ibpasha1/QuranNode/PartImages/71ASBEVHTSL._AC_SL1500_.jpg

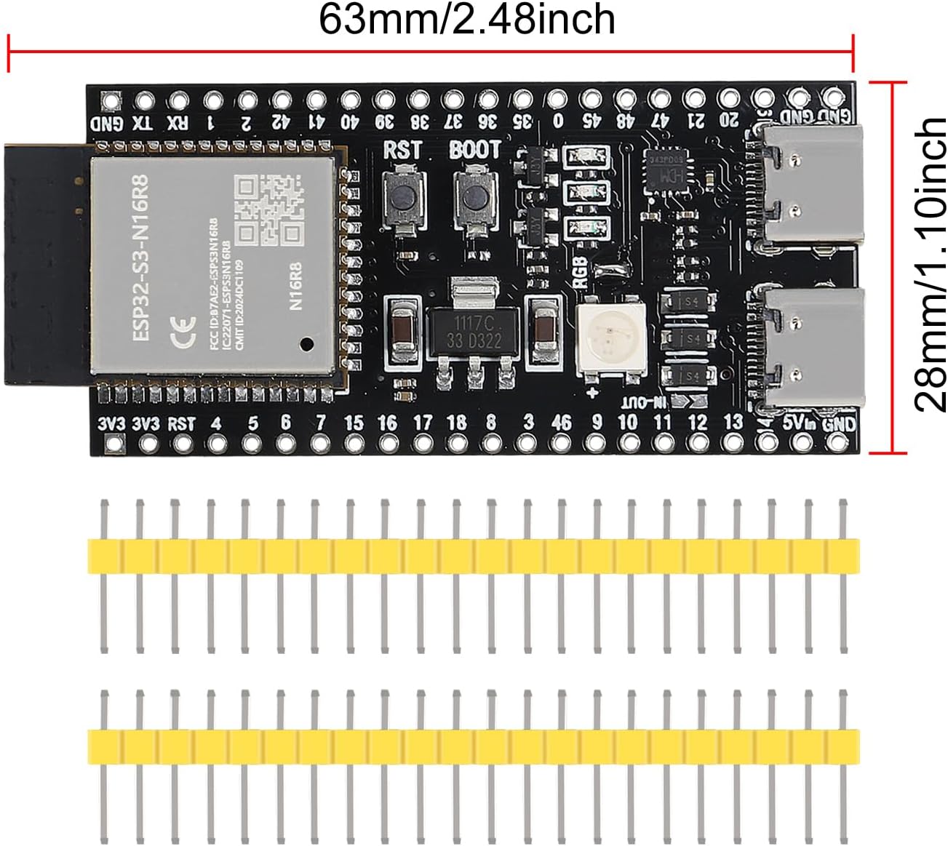
PartImages/71ASBEVHTSL._AC_SL1500_.jpg
