ibpasha1/QuranNode/PartImages/71lFD1bBuXL._AC_SL1500_.jpg

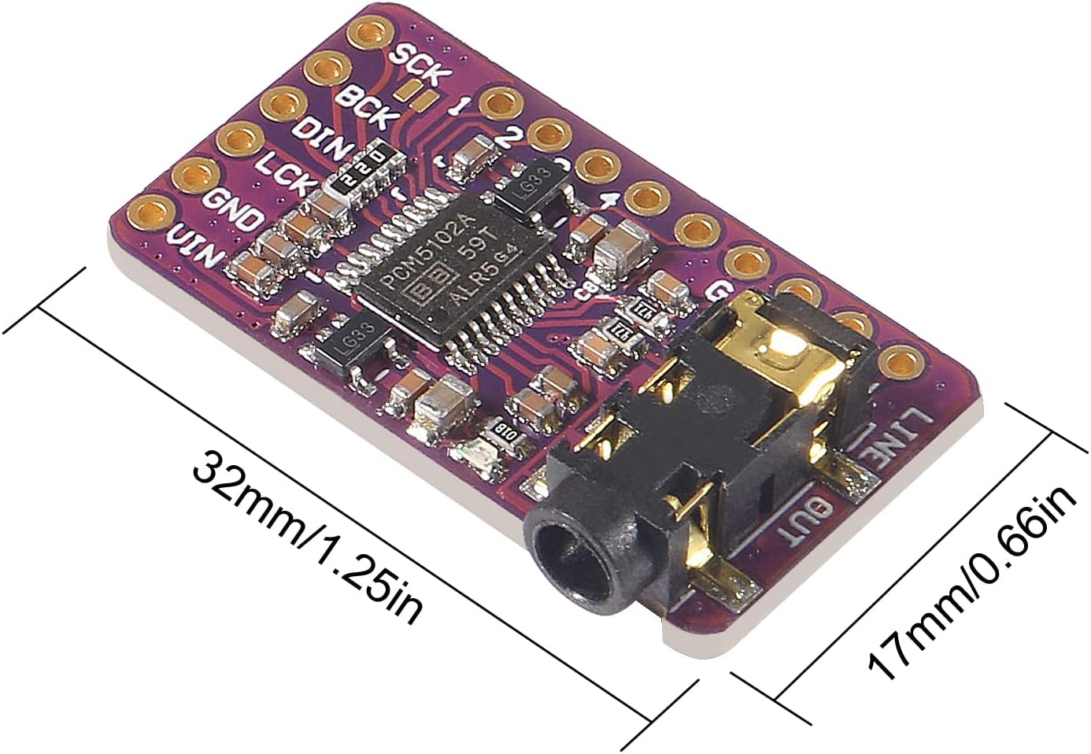
PartImages/71lFD1bBuXL._AC_SL1500_.jpg
