ibpasha1/QuranNode/assets/preview/tajweed/1_7.png

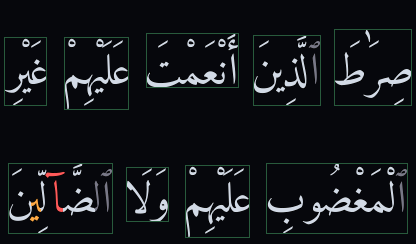
assets/preview/tajweed/1_7.png
