ibpasha1/QuranNode/hardware/enclosure/panelplan.png

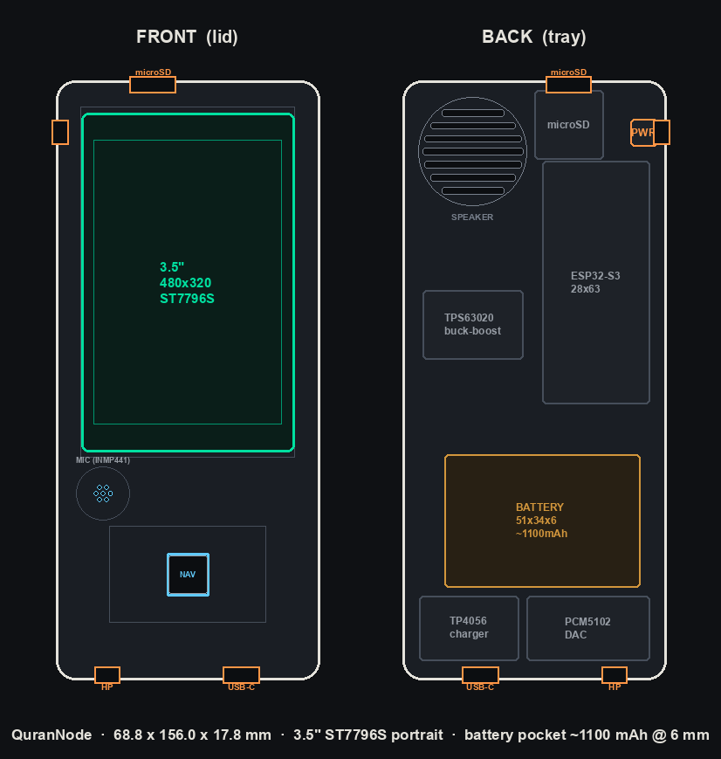
hardware/enclosure/panelplan.png
