ibpasha1/QuranNode/hardware/enclosure/render_exploded.png

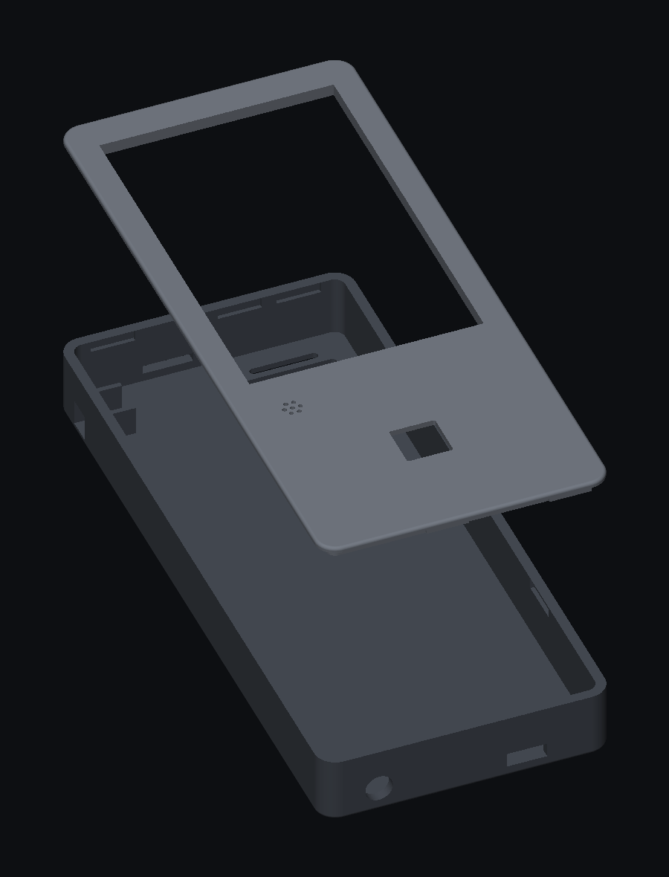
hardware/enclosure/render_exploded.png
