ibpasha1/QuranNode/hardware/enclosure/render_front.png

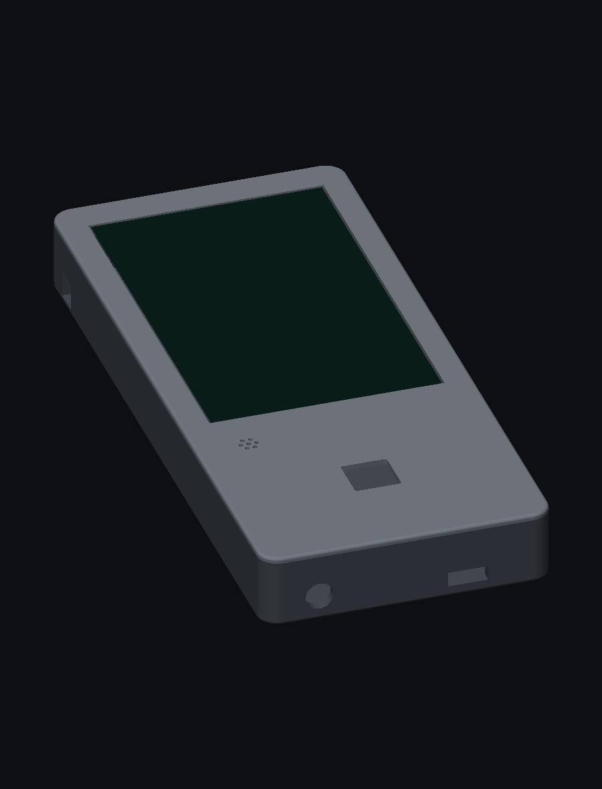
hardware/enclosure/render_front.png
