ibpasha1/QuranNode/hardware/pcb/kicad/qurannode-full.png

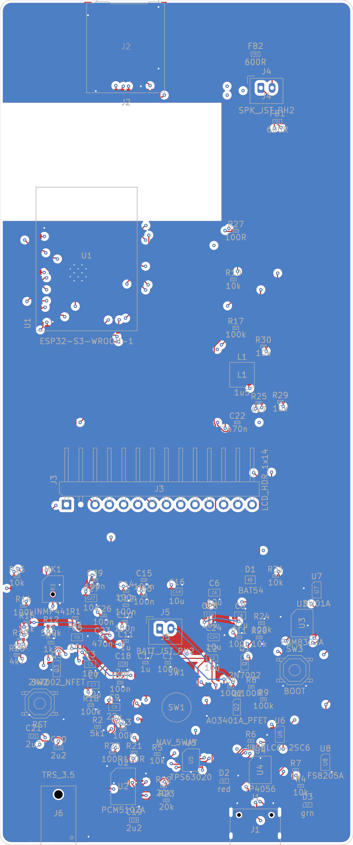
hardware/pcb/kicad/qurannode-full.png
