ibpasha1/QuranNode/hardware/prototype/pinout_preview.png

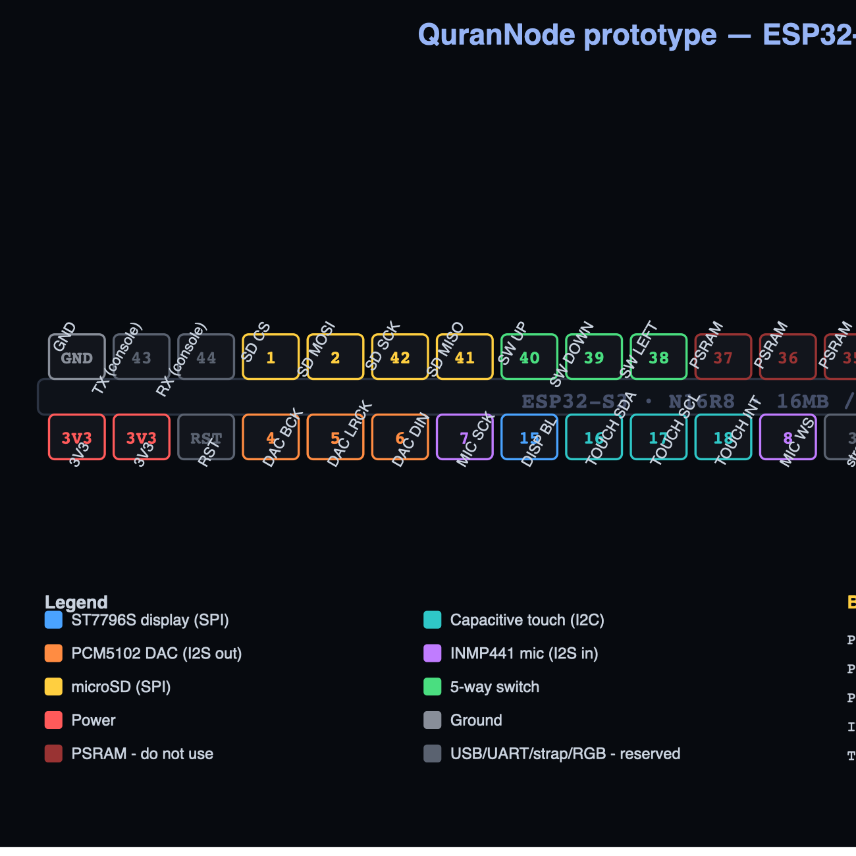
hardware/prototype/pinout_preview.png
