ibpasha1/QuranNode/PartImages/51yFM6gKUXL._SL1001_.jpg

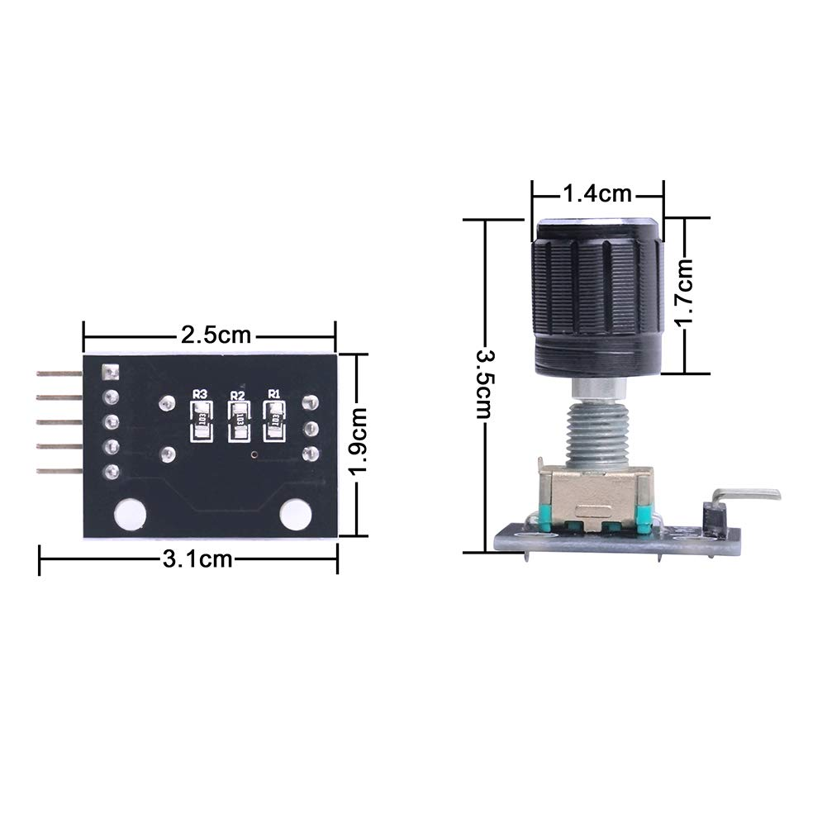
PartImages/51yFM6gKUXL._SL1001_.jpg
