ibpasha1/QuranNode/PartImages/61ehFKd+jKL._AC_SL1001_.jpg

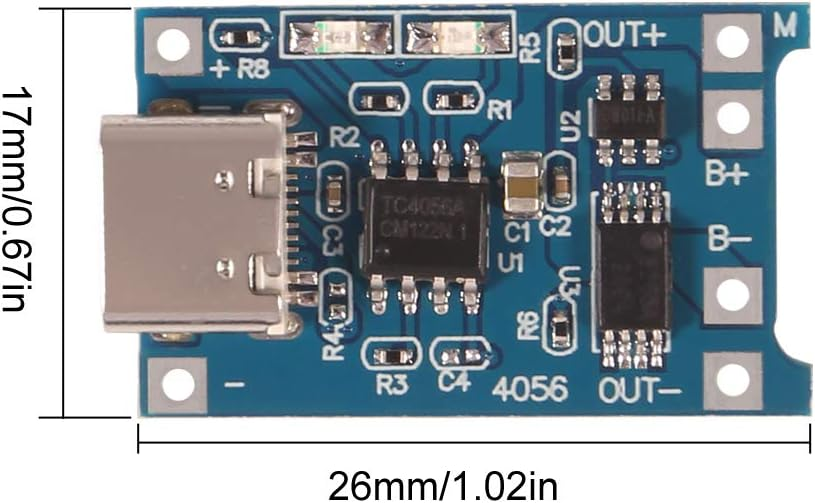
PartImages/61ehFKd+jKL._AC_SL1001_.jpg
