ibpasha1/QuranNode/PartImages/61lymxlfKTL._AC_SL1500_.jpg

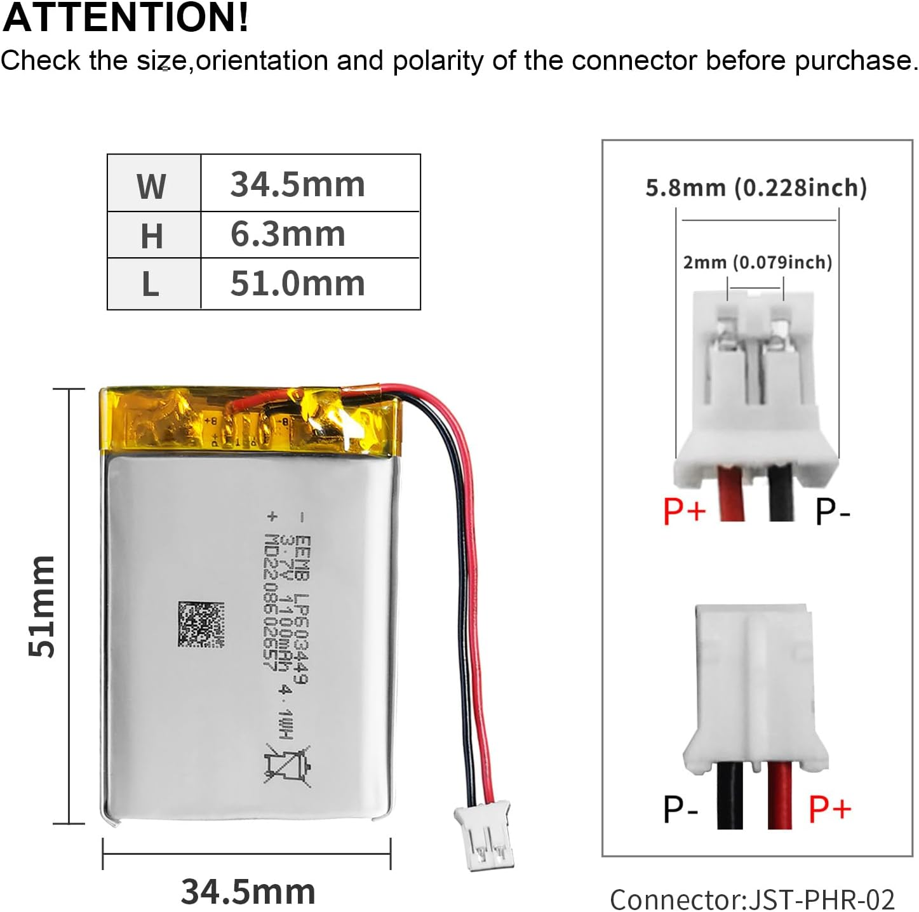
PartImages/61lymxlfKTL._AC_SL1500_.jpg
