ibpasha1/QuranNode/PartImages/61q4yPL2lzL._SL1200_.jpg

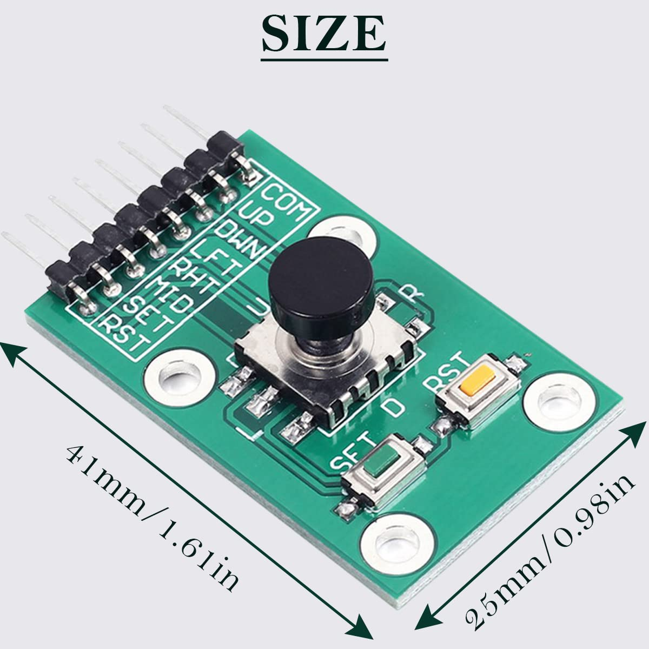
PartImages/61q4yPL2lzL._SL1200_.jpg
