ibpasha1/QuranNode/PartImages/61XXKQeOFkL._SL1000_.jpg

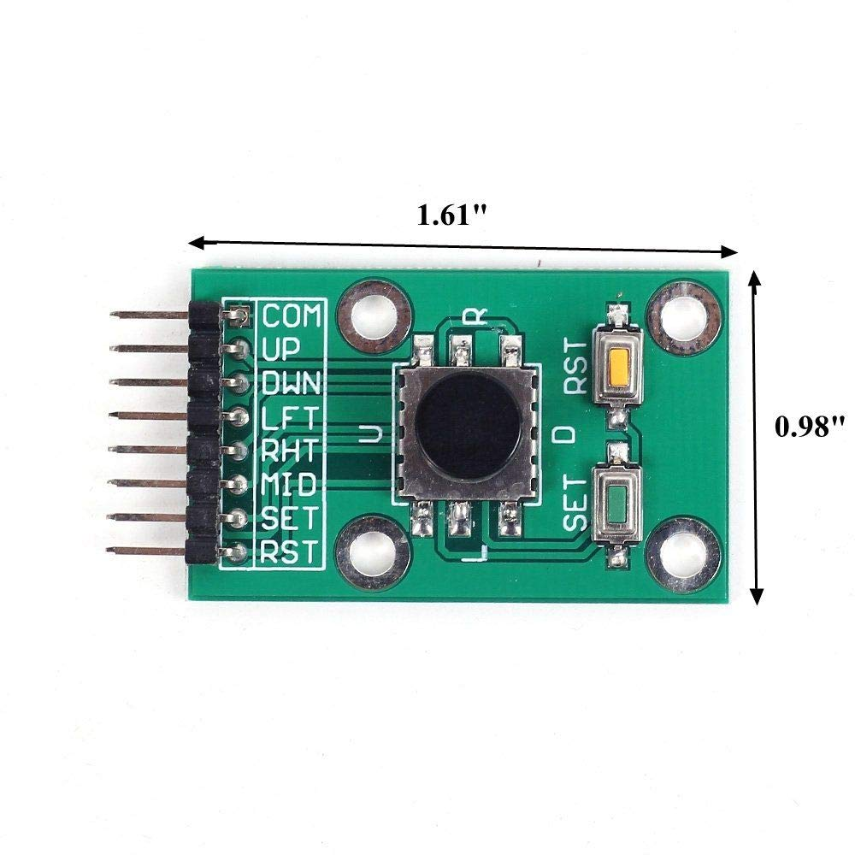
PartImages/61XXKQeOFkL._SL1000_.jpg
