ibpasha1/QuranNode/PartImages/71imCLbJ39L._AC_SL1500_.jpg

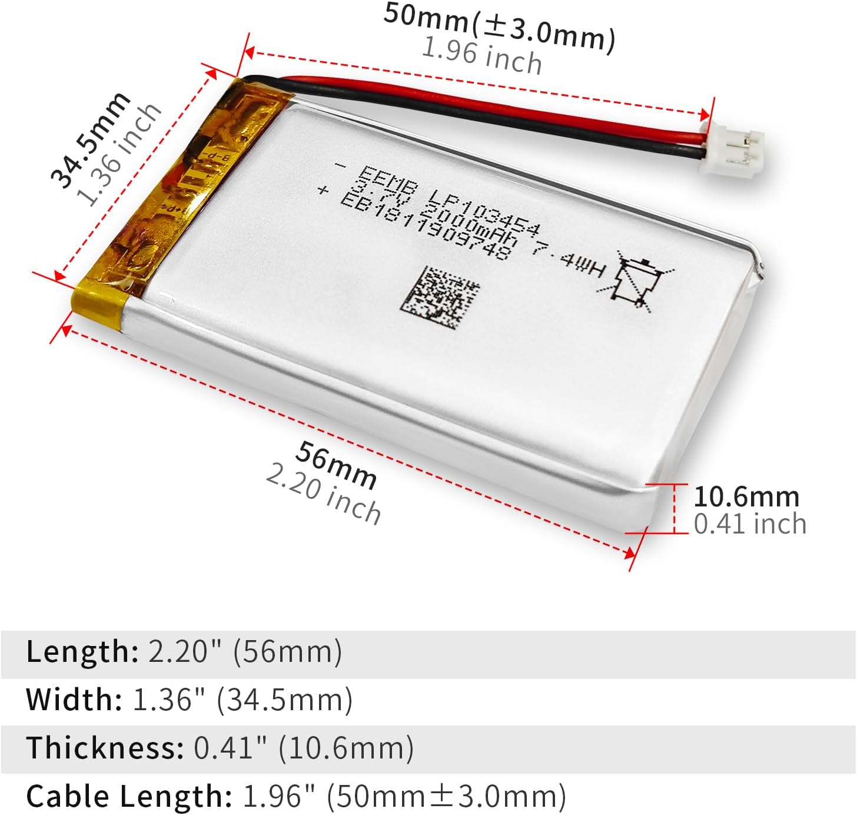
PartImages/71imCLbJ39L._AC_SL1500_.jpg
