ibpasha1/QuranNode/PartImages/71M5cWiFApL._AC_SL1500_.jpg

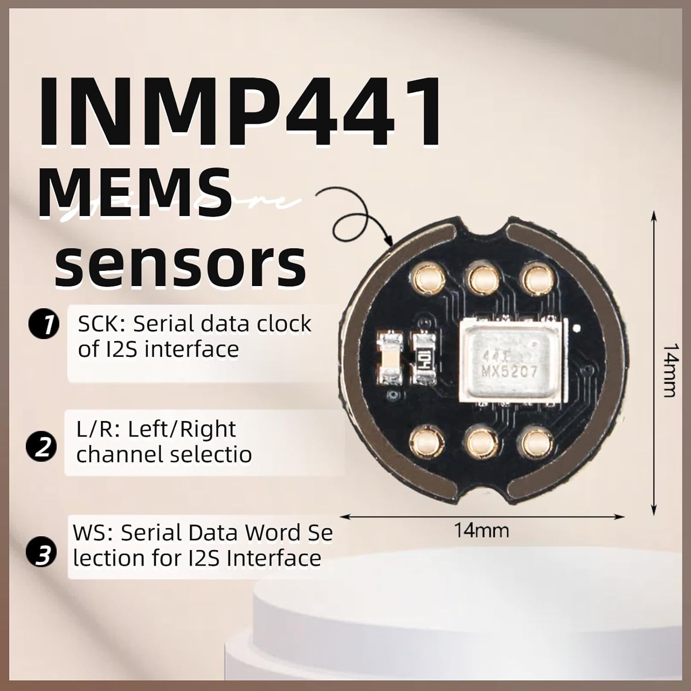
PartImages/71M5cWiFApL._AC_SL1500_.jpg
