ibpasha1/QuranNode/PartImages/71T5YitheYL._AC_SL1500_.jpg

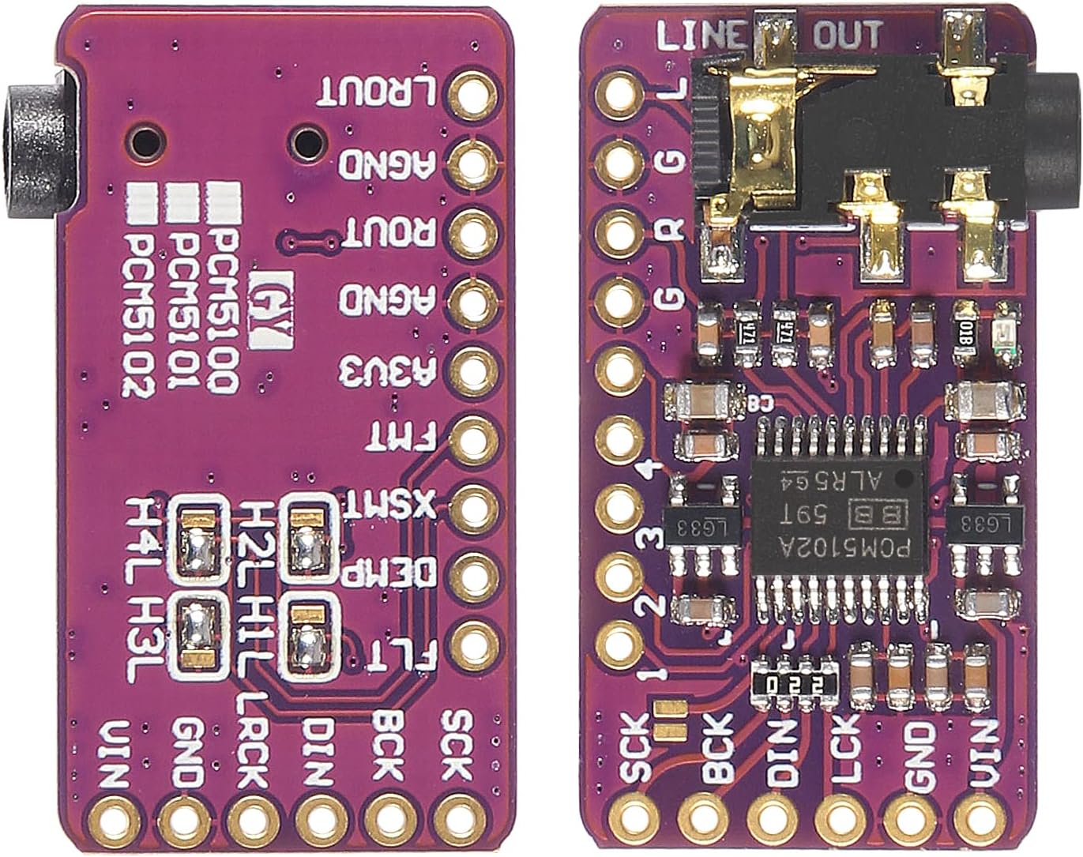
PartImages/71T5YitheYL._AC_SL1500_.jpg
