ibpasha1/QuranNode/PartImages/71UBGr1hEQL._AC_SL1500_.jpg

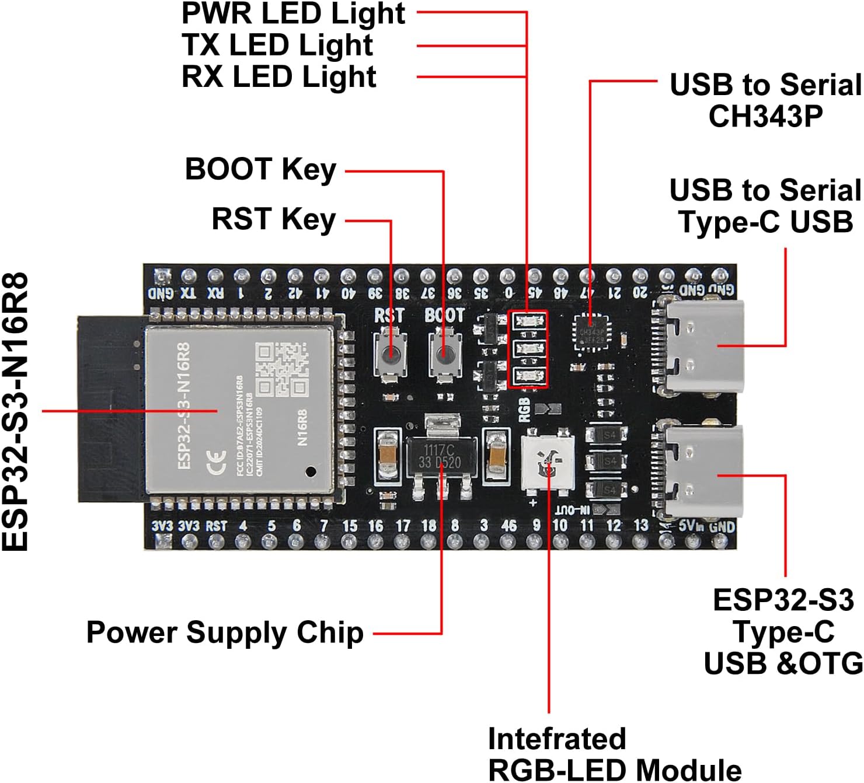
PartImages/71UBGr1hEQL._AC_SL1500_.jpg
