ibpasha1/QuranNode/PartImages/612jbxhP6UL._AC_SL1000_.jpg

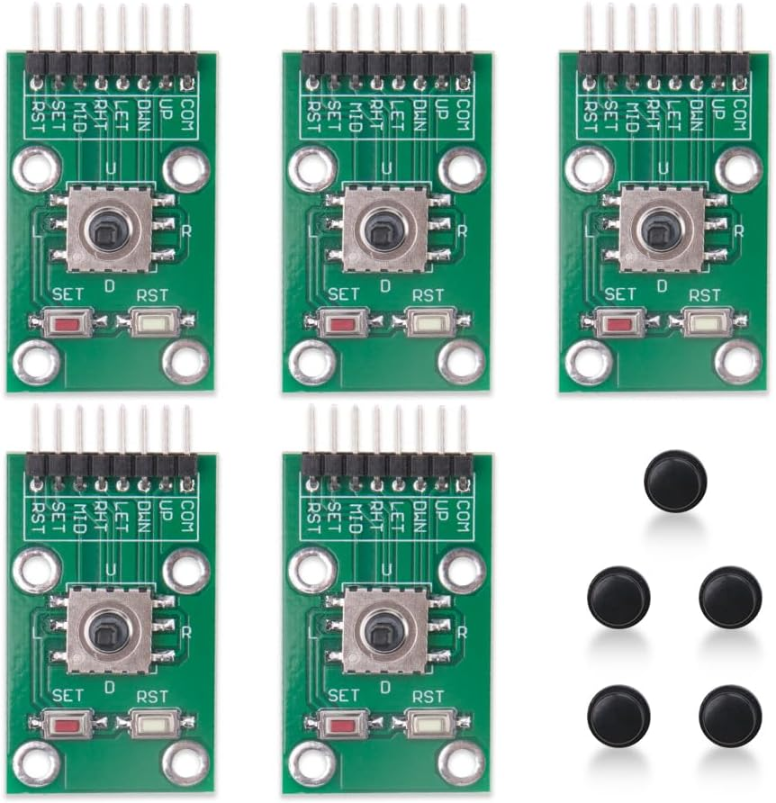
PartImages/612jbxhP6UL._AC_SL1000_.jpg
