ibpasha1/QuranNode/PartImages/616AB7V-gkL._AC_SL1500_.jpg

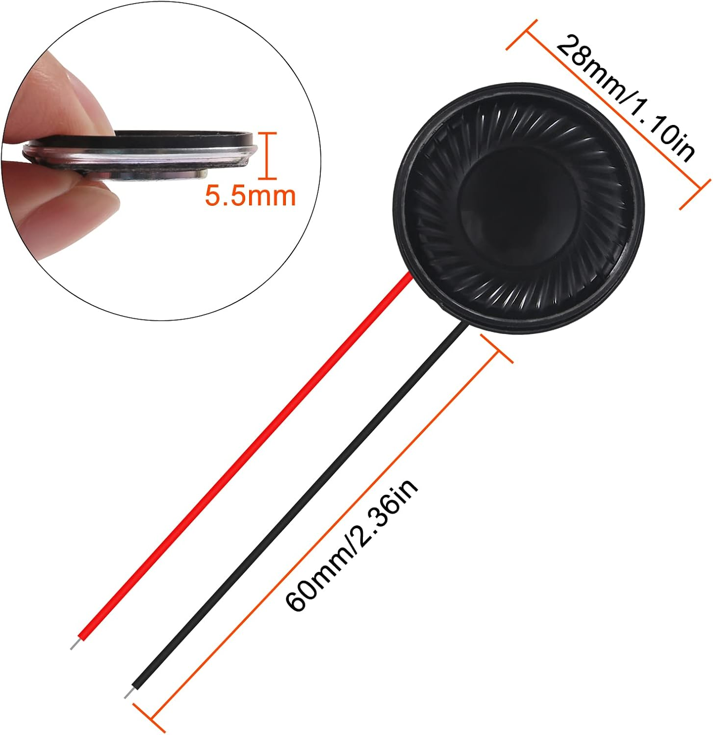
PartImages/616AB7V-gkL._AC_SL1500_.jpg
