ibpasha1/QuranNode/PartImages/Screenshot 2026-08-30 at 1.49.43 PM.png

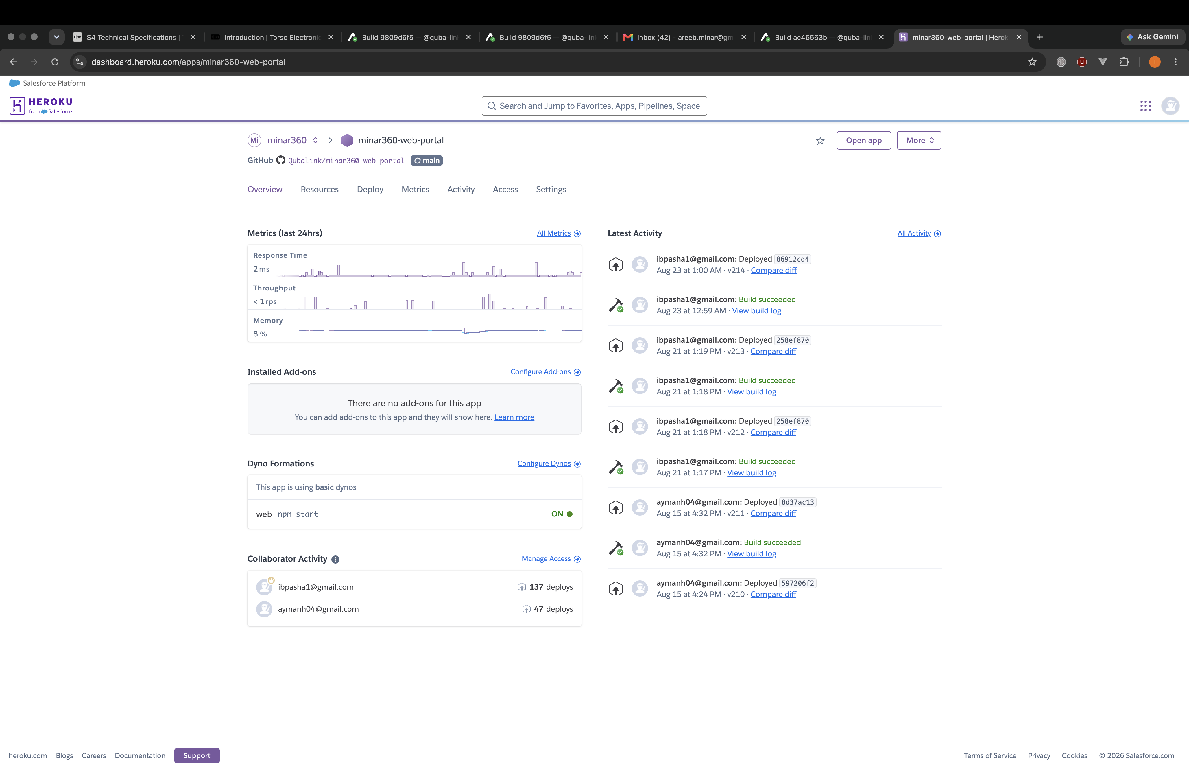
PartImages/Screenshot 2026-08-30 at 1.49.43 PM.png
