ibpasha1/QuranNode/PartImages/Screenshot 2026-08-30 at 2.45.38 PM.png

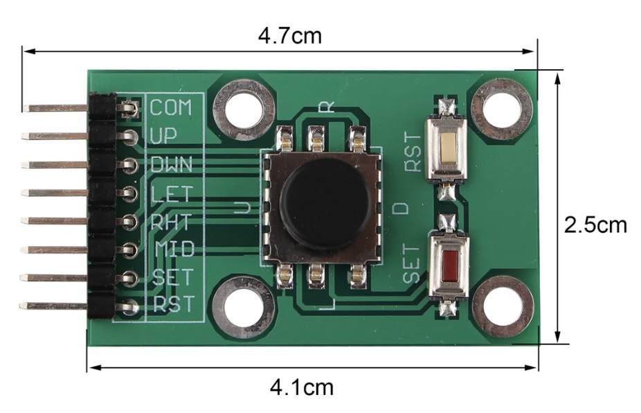
PartImages/Screenshot 2026-08-30 at 2.45.38 PM.png
