ibpasha1/QuranNode/PartImages/Screenshot 2026-08-30 at 2.46.50 PM.png

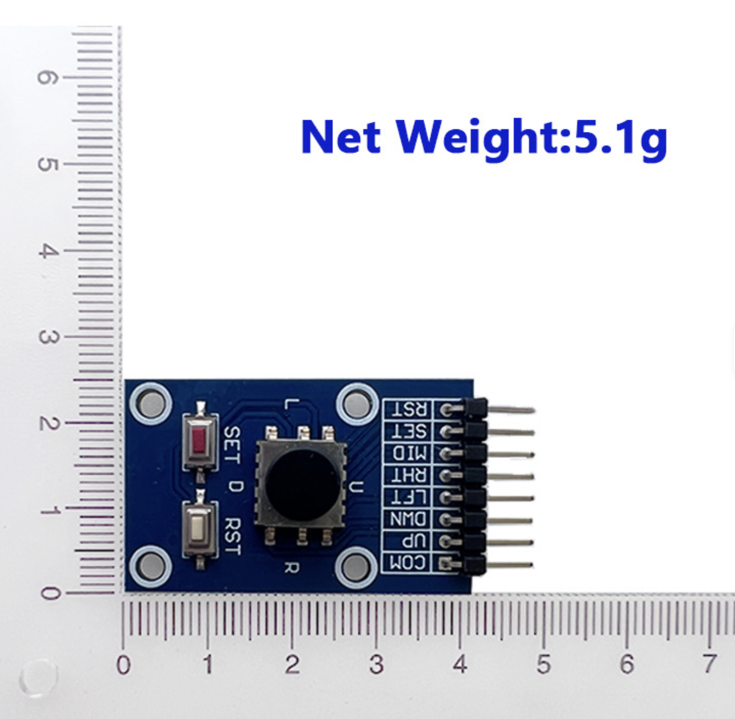
PartImages/Screenshot 2026-08-30 at 2.46.50 PM.png
