ibpasha1/QuranNode/hardware/enclosure/tray.step

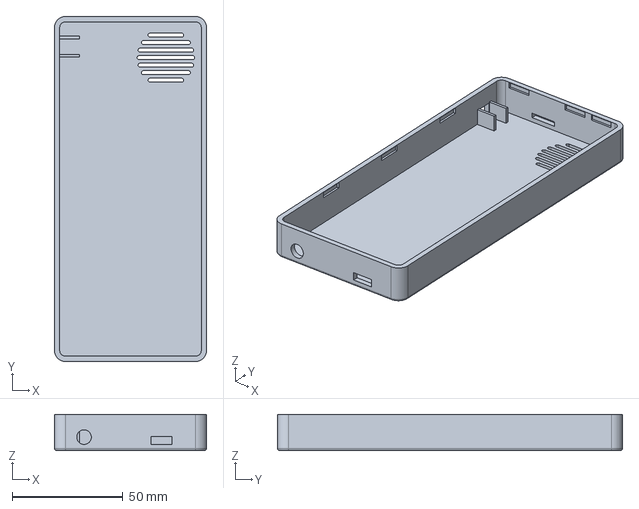
[picture p23: CAD file, 2026-09-13]
hardware/enclosure/tray.step
68.8 x 156.0 x 16.4 mm
