ibpasha1/QuranNode/hardware/pcb/kicad/qurannode-outline.dxf

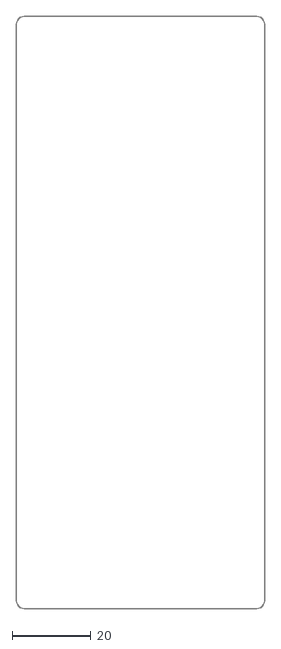
[picture p24: CAD file, 2026-09-16]
hardware/pcb/kicad/qurannode-outline.dxf
62.8 x 150.0
