ibpasha1/QuranNode/hardware/enclosure/lid.step

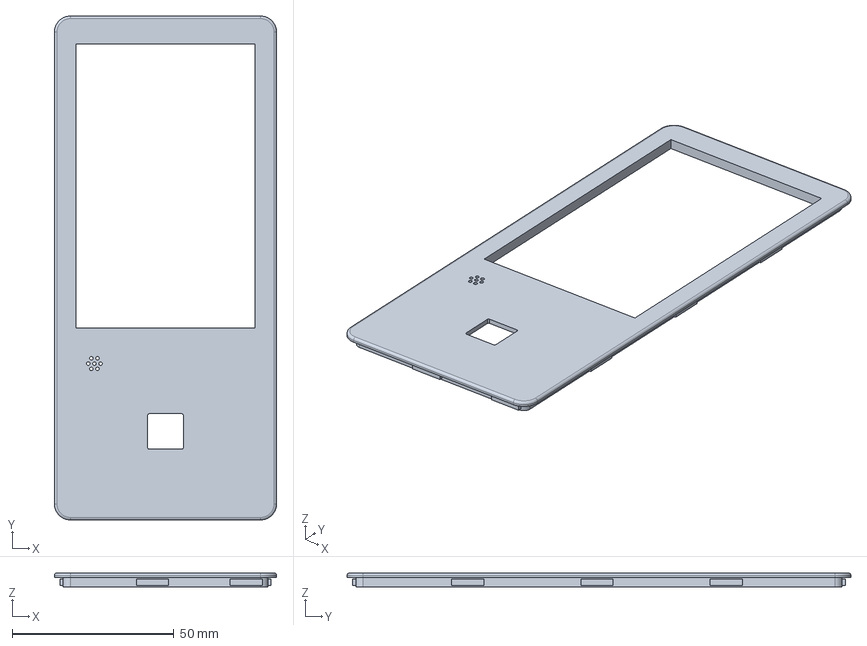
[picture p25: CAD file, 2026-09-13]
hardware/enclosure/lid.step
68.8 x 156.0 x 4.40 mm
