ibpasha1/QuranNode/hardware/enclosure/qurannode_enclosure.step

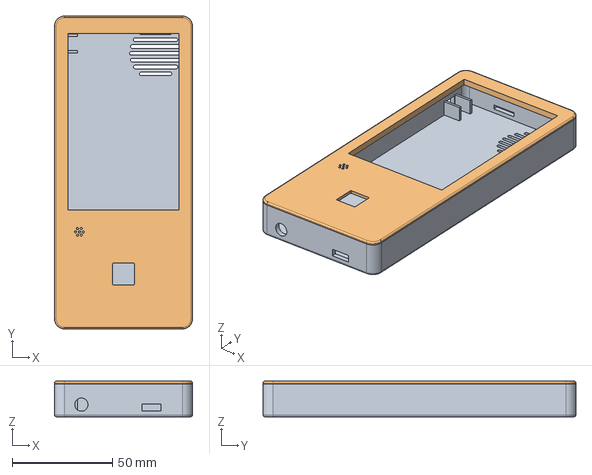
[picture p26: CAD file, 2026-09-13]
hardware/enclosure/qurannode_enclosure.step
68.8 x 156.0 x 17.8 mm
