ibpasha1/QuranNode/(list of files, cad)

Other CAD files:
hardware/enclosure/lid.stl
hardware/enclosure/qurannode_enclosure.FCStd
hardware/enclosure/tray.stl
