ibpasha1/QuranNode/hardware/pcb/kicad/qurannode.kicad_pcb

## KiCad design hardware/pcb/kicad/qurannode.kicad_pcb (2026-09-16)

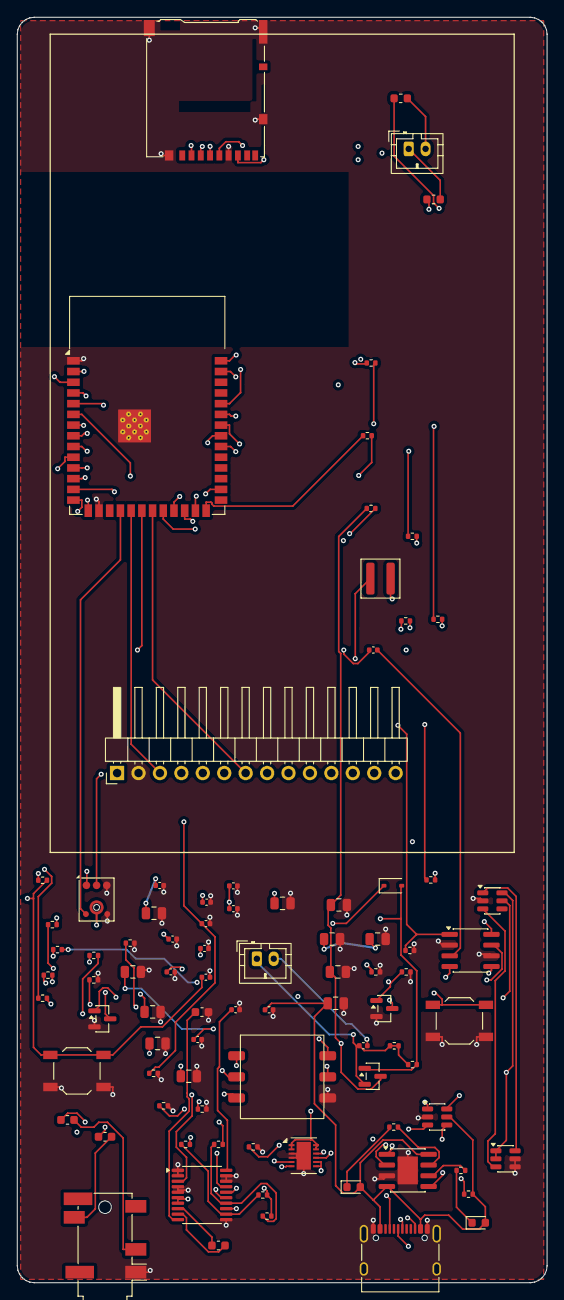
[picture p27: board qurannode.kicad_pcb from above]

Board: 4 copper layers, 62.8 x 150.0 mm, 87 parts (0 on the bottom side), 74 nets.

Parts:
C1, C4, C10, C12, C13, C14, C15, C25, C26, C29: 100n; C_0402_1005Metric
C2, C3, C5, C6, C16, C24, C27, C28: 10u; C_0805_2012Metric
C7, C8, C9: 22u; C_0805_2012Metric
C11, C17: 1u; C_0402_1005Metric
C18, C19, C20, C21: 2u2; C_0603_1608Metric
C22, C23: 470n; C_0402_1005Metric
D1: BAT54; D_SOD-323
D2: red; LED_0603_1608Metric
D3: grn; LED_0603_1608Metric
FB1, FB2: 600R; L_0603_1608Metric
J1: USB-C-16P; USB_C_Receptacle_XKB_U262-16XN-4BVC11
J2: microSD; microSD_HC_Hirose_DM3AT-SF-PEJM5
J3: LCD_HDR_1x14; PinHeader_1x14_P2.54mm_Horizontal
J4: SPK_JST_PH2; JST_PH_B2B-PH-K_1x02_P2.00mm_Vertical
J5: BATT_JST_PH2; JST_PH_B2B-PH-K_1x02_P2.00mm_Vertical
J6: TRS_3.5; Jack_3.5mm_PJ31060-I_Horizontal
L1: 1u5; L_Abracon_ASPIAIG-F4020
MK1: INMP441; Knowles_LGA-6_4.72x3.76mm
Q1: 2N7002; SOT-23
Q2: AO3401A_PFET; SOT-23
Q3: 2N7002_NFET; SOT-23
R1, R2: 5k1; R_0402_1005Metric
R3: 1k2; R_0402_1005Metric
R4, R5, R10, R15, R16, R19, R28, R29, R30, R31: 10k; R_0402_1005Metric
R6, R7: 1k; R_0402_1005Metric
R8, R20, R21, R27: 100R; R_0402_1005Metric
R9, R11, R13, R14, R17, R18, R24: 100k; R_0402_1005Metric
R12: 560k; R_0402_1005Metric
R22, R23: 20k; R_0402_1005Metric
R25, R26: 4k7; R_0402_1005Metric
SW1: NAV_5WAY; NAV_5WAY_SMD
SW2: RST; SW_SPST_TL3342
SW3: BOOT; SW_SPST_TL3342
U1: ESP32-S3-WROOM-1
U2: PCM5102A; TSSOP-20_4.4x6.5mm_P0.65mm
U3: PAM8302A; SOIC-8_3.9x4.9mm_P1.27mm
U4: TP4056; SOIC-8-1EP_3.9x4.9mm_P1.27mm_EP2.41x3.3mm
U5: TPS63020; DFN-12-1EP_3x4mm_P0.5mm_EP1.7x3.3mm
U6: USBLC6-2SC6; SOT-23-6
U7: DW01A; SOT-23-6
U8: FS8205A; SOT-23-6

Connections:
+3V3: C7.1, C8.1, C9.1, C10.1, C13.1, C14.1, C15.1, C16.1, C26.1, C27.1, C28.1, C29.1, J2.4, J3.1, MK1.3, R12.1, R14.2, R15.1, R16.1, R19.2, R25.2, R26.2, R29.2, R30.2, R31.2, U1.2, U2.6, U2.7, U2.13, U5.7, U5.8
AIN: C22.1, R22.2, R23.2
AMP_EN: R24.1, U1.11, U3.1
BL_G: Q1.1, R27.2, R28.1
CHG_CHRG: R6.2, U4.7
CHG_STBY: R7.2, U4.6
DISP_BL: R27.1, U1.8
DISP_CLK: J3.7, U1.21
DISP_CS: J3.3, U1.19
DISP_DC: J3.5, U1.22
DISP_MOSI: J3.6, U1.20
DISP_RST: J3.4, J3.11, U1.23
EN: C11.1, R15.2, SW2.1, U1.3
GND: C1.2, C2.2, C3.2, C5.2, C6.2, C7.2, C8.2, C9.2, C10.2, C11.2, C12.2, C13.2, C14.2, C15.2, C16.2, C17.2, C18.2, C23.2, C24.2, C25.2, C26.2, C27.2, C28.2, C29.2, J1.A1, J1.A12, J1.B1, J1.B12, J1.SH, J2.6, J2.SH, J3.2, J6.S, MK1.4, MK1.5, Q1.2, Q3.2, R1.2, R2.2, R3.2, R5.2, R11.2, R13.2, R18.2, R24.2, R28.2, SW1.6, SW2.2, SW3.2, U1.1, U1.16, U1.41, U2.1, U2.2, U2.4, U2.5, U2.11, U2.18, U2.19, U3.2, U3.6, U4.3, U4.9, U5.3, U5.4, U5.13, U6.2, U7.2, U8.4, U8.5
HOLD_G: Q3.1, R10.2, R11.1
HP_L: C20.2, J6.T
HP_R: C21.2, J6.R1
I2S_BCK: U1.4, U2.16
I2S_DATA: U1.6, U2.17
I2S_WS: U1.5, U2.15
IO0: R16.2, SW3.1, U1.28
MIC_SCK: MK1.1, U1.7
MIC_SD: MK1.2, U1.18
MIC_WS: MK1.6, U1.12
unnamed: J1.A5, R1.1
unnamed: J1.B5, R2.1
unnamed: J1.A6, U6.1
unnamed: J1.A7, U6.3
unnamed: R3.1, U4.2
unnamed: R4.1, R5.1, U4.1
unnamed: D2.1, R6.1
unnamed: D3.1, R7.1
unnamed: C4.2, J5.2, U7.6, U8.1, U8.2
unnamed: U7.1, U8.6
unnamed: U7.3, U8.3
unnamed: L1.1, U5.10
unnamed: L1.2, U5.9
unnamed: R12.2, R13.1, U5.5
unnamed: C17.1, U2.20
unnamed: C18.1, U2.10
unnamed: C19.1, U2.8
unnamed: C19.2, U2.9
unnamed: R19.1, U2.3
unnamed: C20.1, R20.2
unnamed: C21.1, R21.2
unnamed: C22.2, U3.3
unnamed: C23.1, U3.4
unnamed: FB1.1, U3.8
unnamed: FB2.1, U3.5
unnamed: J3.8, Q1.3
NAV_DN: SW1.2, U1.33
NAV_L: SW1.3, U1.32
NAV_MID: D1.1, SW1.5, U1.24
NAV_R: SW1.4, U1.25
NAV_UP: SW1.1, U1.34
OUTL: R20.1, R22.1, U2.12
OUTR: R21.1, R23.1, U2.14
PG: R14.1, U5.6
PWR_G: D1.2, Q2.1, Q3.3, R9.2
PWR_HOLD: R10.1, U1.26
SD_CLK: J2.5, U1.36
SD_CS: J2.2, R29.1, U1.40
SD_MISO: J2.7, R31.1, U1.35
SD_MOSI: J2.3, R30.1, U1.39
SPK_N: FB2.2, J4.2
SPK_P: FB1.2, J4.1
TOUCH_SCL: J3.10, R26.1, U1.10
TOUCH_SDA: J3.12, R25.1, U1.9
USB_DM: U1.13, U6.6
USB_DP: U1.14, U6.4
VBAT: C3.1, C4.1, J5.1, Q2.2, R8.1, R8.2, R9.1, U4.5, U7.5
VBAT_SENSE: C12.1, R17.2, R18.1, U1.15
VBUS: C1.1, C2.1, D2.2, D3.2, J1.A4, J1.A9, J1.B4, J1.B9, R4.2, U4.4, U4.8, U6.5
VSYS: C5.1, C6.1, C24.1, C25.1, Q2.3, R17.1, U3.7, U5.1, U5.2, U5.11, U5.12
