ibpasha1/QuranNode/core/scene/scene_nav.c

// scene_nav.c — jump navigation (Surah / Juz / Page / Bookmarks).
//
// Replaces endless scrolling: pick a way in (by surah, by juz, by mushaf page,
// or a saved bookmark) and land in the reader at that exact ayah. Surahs that
// aren't in the bundled sample yet are shown dimmed so it's clear what has
// content, and each entry carries how much of it you've already read.
#include "scene.h"
#include "player.h"
#include "progress.h"
#include "prefs.h"
#include "khatm.h"
#include "quran_db.h"
#include "theme.h"
#include "font.h"
#include "canvas.h"
#include "input_accel.h"
#include "hal.h"
#include "plat.h"
#include <stdio.h>
#include <string.h>

typedef enum { NAV_ROOT, NAV_SURAH, NAV_JUZ, NAV_PAGE, NAV_BOOKMARKS,
               NAV_MODE_COUNT } NavMode;

static NavMode s_mode = NAV_ROOT;
static int s_sel[NAV_MODE_COUNT];      // selection per mode
static int s_scroll[NAV_MODE_COUNT];   // scroll per mode
static InputAccel s_accel;   // hold-to-scroll ramp for the long lists

#define ROW_H 18
#define LIST_TOP 28
#define VIS ((CANVAS_HEIGHT - 16 - LIST_TOP) / ROW_H)

// Root rows are taller "launcher" entries with an icon and a right-hand detail.
#define ROOT_ROW_H 34

// A surah is "available" when its glyph pack for the current font/tajweed prefs
// is actually on the card. This used to be hardcoded to `surah == 1` from the
// days only Al-Fatihah shipped; now the full library is on SD, so we ask the
// filesystem. Cached (0 unknown / 1 yes / -1 no) because the nav lists re-query
// every visible row every frame and hal_fs_exists() hits the slow SD card; the
// cache is rebuilt when the size or tajweed toggle picks a different pack dir.
// Al-Fatihah is always available — it's baked into flash as the no-SD safety net.
static bool content_available(int surah)
{
    if (surah < 1 || surah > QDB_SURAH_COUNT) return false;
    if (surah == 1) return true;
    static int8_t cache[QDB_SURAH_COUNT + 1];
    static int cache_size = -1, cache_tj = -1;
    if (cache_size != g_prefs.font_size || cache_tj != (int)g_prefs.tajweed) {
        memset(cache, 0, sizeof(cache));
        cache_size = g_prefs.font_size;
        cache_tj = (int)g_prefs.tajweed;
    }
    if (!cache[surah])
        cache[surah] = hal_fs_exists(prefs_font_pack(surah)) ? 1 : -1;
    return cache[surah] > 0;
}

// --- "Resume or start over?" prompt for a partially-read surah -------------
// Opening a surah you've already begun shouldn't silently restart it. When it's
// partway read we ask; "resume" lands on the first ayah you haven't read yet
// (or the exact global last-position when that surah is the one you left off in).
static bool s_resume_prompt = false;
static int  s_prompt_surah = 0;
static int  s_prompt_ayah = 1;     // where "resume" jumps
static int  s_prompt_sel = 0;      // 0 = resume, 1 = start over

static int surah_resume_ayah(int surah)
{
    ResumePoint r = progress_resume();
    if (progress_has_resume() && r.surah == surah && r.ayah >= 1)
        return r.ayah;                          // exact spot you left off
    int n = qdb_ayah_count(surah);
    for (int a = 1; a <= n; a++)
        if (!khatm_is_read(surah, a)) return a;  // first unread ayah
    return 1;                                    // fully read -> start over
}

// Root launcher rows. Keep in sync with ROOT_ROWS in render_root() and enter().
#define N_ROOT 6

static int list_count(void)
{
    switch (s_mode) {
    case NAV_ROOT:      return N_ROOT;
    case NAV_SURAH:     return QDB_SURAH_COUNT;
    case NAV_JUZ:       return QDB_JUZ_COUNT;
    case NAV_PAGE:      return QDB_PAGE_COUNT;
    case NAV_BOOKMARKS: return progress_bookmark_count();
    default:            return 0;
    }
}

// "100%" / "42%" / "" when untouched — the read fraction of a list entry.
static void pct_str(float frac, char *b, int n)
{
    int p = (int)(frac * 100.f + 0.5f);
    if (p <= 0) b[0] = 0;
    else snprintf(b, n, "%d%%", p);
}

// Colour a completion percentage at a glance: green when finished, gold while
// in progress, dim when untouched.
static color_t frac_color(float frac)
{
    int p = (int)(frac * 100.f + 0.5f);
    if (p >= 100) return THEME_ACTIVE;   // green — fully read
    if (p > 0)    return THEME_ACCENT;    // gold — partway through
    return THEME_DIM;                     // untouched
}

// Fill the three columns of a list row: leading index (soft blue), main name,
// and a right-aligned detail (dim). Any column may come back empty.
static void row_cols(int i, char *idx, int ni, char *name, int nn,
                     char *detail, int nd, bool *dim, float *frac)
{
    idx[0] = name[0] = detail[0] = 0;
    *dim = false;
    *frac = -1.f;   // no completion figure for this row
    switch (s_mode) {
    case NAV_ROOT:
        break;   // root uses its own launcher rows
    case NAV_SURAH: {
        int s = i + 1;
        *frac = khatm_surah_frac(s);
        snprintf(idx, ni, "%d", s);
        snprintf(name, nn, "%s", qdb_surah_name(s));
        snprintf(detail, nd, "%d ayat", qdb_ayah_count(s));
        *dim = !content_available(s);
        break;
    }
    case NAV_JUZ: {
        int j = i + 1;
        QRef r = qdb_juz_start(j);
        *frac = khatm_juz_frac(j);
        snprintf(idx, ni, "%d", j);
        snprintf(name, nn, "%s", qdb_surah_name(r.surah));
        snprintf(detail, nd, "p%d", qdb_juz_page(j));
        *dim = !content_available(r.surah);
        break;
    }
    case NAV_PAGE: {
        int p = i + 1;
        QRef r = qdb_page_start(p);
        *frac = khatm_page_frac(p);
        snprintf(idx, ni, "%d", p);
        snprintf(name, nn, "%s", qdb_surah_name(r.surah));
        snprintf(detail, nd, "%d:%d", r.surah, r.ayah);
        *dim = !content_available(r.surah);
        break;
    }
    case NAV_BOOKMARKS: {
        Bookmark b = progress_bookmark(i);
        snprintf(name, nn, "%s", qdb_surah_name(b.surah));
        snprintf(detail, nd, "%d:%d", b.surah, b.ayah);
        *dim = !content_available(b.surah);
        break;
    }
    default: break;
    }
}

static void jump_to(int surah, int ayah)
{
    player_set_rate(&g_player, g_prefs.rate);
    player_load(&g_player, surah, ayah);
    scene_switch(SCENE_READER);
}

static const char *mode_title(void)
{
    switch (s_mode) {
    case NAV_ROOT: return "NAVIGATE";
    case NAV_SURAH: return "NAVIGATE / SURAH";
    case NAV_JUZ: return "NAVIGATE / JUZ";
    case NAV_PAGE: return "NAVIGATE / PAGE";
    case NAV_BOOKMARKS: return "NAVIGATE / BOOKMARKS";
    default: return "";
    }
}

// The root menu as launcher rows: icon, name, and a live detail line.
static const struct { const char *label; UiIcon icon; } ROOT_ROWS[N_ROOT] = {
    { "By Surah",  ICON_NOTE },
    { "By Juz",    ICON_FOLDER },
    { "By Page",   ICON_BOOK },
    { "Bookmarks", ICON_INFO },
    { "Progress",  ICON_INFO },
    { "Settings",  ICON_GEAR },
};

static void render_root(Canvas *c)
{
    int sel = s_sel[NAV_ROOT];
    for (int i = 0; i < N_ROOT; i++) {
        int y = LIST_TOP + 6 + i * (ROOT_ROW_H + 6);
        bool is_sel = (i == sel);
        char detail[24];
        switch (i) {
        case 0:  snprintf(detail, sizeof(detail), "114"); break;
        case 1:  snprintf(detail, sizeof(detail), "30"); break;
        case 2:  snprintf(detail, sizeof(detail), "604"); break;
        case 3:  snprintf(detail, sizeof(detail), "%d", progress_bookmark_count()); break;
        case 4:  snprintf(detail, sizeof(detail), "%d%%",
                          (int)(khatm_stats()->percent + 0.5f)); break;
        default: detail[0] = 0; break;
        }
        bool dim = (i == 3 && progress_bookmark_count() == 0);

        if (is_sel) theme_sel_block(c, 6, y, CANVAS_WIDTH - 12, ROOT_ROW_H);
        else        canvas_rect(c, 6, y, CANVAS_WIDTH - 12, ROOT_ROW_H, THEME_GRID);

        color_t fg = is_sel ? THEME_SEL_TEXT : (dim ? THEME_DIM : THEME_TEXT);
        theme_icon(c, 18, y + (ROOT_ROW_H - 9) / 2, ROOT_ROWS[i].icon,
                   is_sel ? THEME_SEL_TEXT : THEME_LABEL,
                   is_sel ? THEME_SEL_BG : THEME_BG);
        font_draw_string(c, 38, y + (ROOT_ROW_H - 14) / 2, &font_small, ROOT_ROWS[i].label, fg);
        if (detail[0])
            font_draw_string_right(c, CANVAS_WIDTH - 18, y + (ROOT_ROW_H - 7) / 2,
                                   &font_tiny, detail,
                                   is_sel ? THEME_SEL_TEXT : THEME_DIM);
    }
}

static void render_resume_prompt(Canvas *c)
{
    theme_header(c, "RESUME?", THEME_TITLE, NULL, THEME_DIM);
    int pct = (int)(khatm_surah_frac(s_prompt_surah) * 100.f + 0.5f);
    int y = CANVAS_HEIGHT / 2 - 46;
    canvas_rect_fill(c, 20, y, CANVAS_WIDTH - 40, 92, THEME_PANEL);
    canvas_rect(c, 20, y, CANVAS_WIDTH - 40, 92, THEME_ACCENT);

    char l1[40];
    snprintf(l1, sizeof l1, "%s  %d%%", qdb_surah_name(s_prompt_surah), pct);
    font_draw_string_centered(c, y + 10, &font_small, l1, THEME_TEXT);

    char opt0[28];
    snprintf(opt0, sizeof opt0, "Resume  %d:%d", s_prompt_surah, s_prompt_ayah);
    int oy0 = y + 40, oy1 = y + 62;
    theme_sel_block(c, 28, (s_prompt_sel == 0 ? oy0 : oy1) - 3, CANVAS_WIDTH - 56, 15);
    font_draw_string_centered(c, oy0, &font_tiny, opt0,
                              s_prompt_sel == 0 ? THEME_SEL_TEXT : THEME_TEXT);
    font_draw_string_centered(c, oy1, &font_tiny, "Start from beginning",
                              s_prompt_sel == 1 ? THEME_SEL_TEXT : THEME_TEXT);

    KeyChip chips[3] = {
        { "^v", "CHOOSE", 2, { INPUT_NAV_UP, INPUT_NAV_DOWN } },
        { "OK", "SELECT", 2, { INPUT_NAV_SELECT, INPUT_ENC_PUSH } },
        { "BK", "CANCEL", 1, { INPUT_BTN_BACK } },
    };
    theme_keybar(c, chips, 3);
}

static void on_render(Canvas *c)
{
    theme_clear(c);
    if (s_resume_prompt) { render_resume_prompt(c); return; }

    int count = list_count();
    int sel = s_sel[s_mode], scroll = s_scroll[s_mode];

    // Header with a breadcrumb title and a "position/total" readout on lists.
    char right[16] = "";
    if (s_mode != NAV_ROOT && count > 0)
        snprintf(right, sizeof(right), "%d/%d", sel + 1, count);
    theme_header(c, mode_title(), THEME_TITLE, right[0] ? right : NULL, THEME_DIM);

    KeyChip chips[3] = {
        { "^v", s_mode == NAV_ROOT ? "CHOOSE" : "SCROLL", 4,
          { INPUT_NAV_UP, INPUT_NAV_DOWN, INPUT_ENC_CW, INPUT_ENC_CCW } },
        { "OK", "OPEN", 2, { INPUT_NAV_SELECT, INPUT_ENC_PUSH } },
        { "BK", s_mode == NAV_ROOT ? "HOME" : "BACK", 1, { INPUT_BTN_BACK } },
    };

    if (s_mode == NAV_ROOT) {
        render_root(c);
        theme_keybar(c, chips, 3);
        return;
    }

    if (count == 0) {
        font_draw_string_centered(c, CANVAS_HEIGHT / 2 - 4, &font_small,
                                  "Nothing here yet", THEME_DIM);
        theme_hint(c, "BACK up");
        return;
    }

    for (int r = 0; r < VIS && scroll + r < count; r++) {
        int i = scroll + r;
        int y = LIST_TOP + r * ROW_H;
        bool is_sel = (i == sel), dim = false;
        float frac = -1.f;
        char idx[8], name[28], detail[16];
        row_cols(i, idx, sizeof(idx), name, sizeof(name),
                 detail, sizeof(detail), &dim, &frac);
        if (is_sel) theme_sel_block(c, 0, y, CANVAS_WIDTH, ROW_H - 1);
        color_t nc = is_sel ? THEME_SEL_TEXT : (dim ? THEME_DIM : THEME_TEXT);
        color_t ic = is_sel ? THEME_SEL_TEXT : THEME_LABEL;
        color_t dc = is_sel ? THEME_SEL_TEXT : THEME_DIM;
        if (idx[0]) font_draw_string_right(c, 36, y + 3, &font_small, idx, ic);
        font_draw_string(c, 46, y + 3, &font_small, name, nc);
        // Right edge: a completion % coloured by how much is read (green done,
        // gold in progress), with the plain detail to its left.
        int right = CANVAS_WIDTH - 10;
        char pct[8] = {0};
        if (frac >= 0.f) pct_str(frac, pct, sizeof pct);
        if (pct[0]) {
            color_t pc = is_sel ? THEME_SEL_TEXT : frac_color(frac);
            font_draw_string_right(c, right, y + 6, &font_tiny, pct, pc);
            right -= font_string_width(&font_tiny, pct) + 6;
        }
        if (detail[0])
            font_draw_string_right(c, right, y + 6, &font_tiny, detail, dc);
    }

    // Scrollbar.
    if (count > VIS) {
        int track = VIS * ROW_H;
        int th = track * VIS / count; if (th < 8) th = 8;
        int ty = LIST_TOP + (track - th) * sel / (count - 1);
        canvas_rect_fill(c, CANVAS_WIDTH - 3, ty, 3, th, THEME_ACCENT);
    }

    theme_keybar(c, chips, 3);
}

static void move(int dir)
{
    int count = list_count();
    if (count == 0) return;
    // Hold-to-scroll: repeated events in one direction ramp the step size, so
    // holding a key sweeps the 114-surah list instead of crawling it.
    int step = input_accel_step(&s_accel, dir, plat_millis());
    int *sel = &s_sel[s_mode], *scroll = &s_scroll[s_mode];
    int was = *sel;
    *sel += dir * step;
    if (*sel < 0) *sel = 0;
    if (*sel >= count) *sel = count - 1;
    if (*sel < *scroll) *scroll = *sel;
    if (*sel >= *scroll + VIS) *scroll = *sel - VIS + 1;
    if (*sel != was) hal_audio_click(false);
}

static void enter(void)
{
    hal_audio_click(true);
    int sel = s_sel[s_mode];
    switch (s_mode) {
    case NAV_ROOT:
        switch (sel) {
        case 0: s_mode = NAV_SURAH; break;
        case 1: s_mode = NAV_JUZ; break;
        case 2: s_mode = NAV_PAGE; break;
        case 3: s_mode = NAV_BOOKMARKS; break;
        case 4: scene_switch(SCENE_PROGRESS); return;
        default: scene_switch(SCENE_SETTINGS); return;
        }
        break;
    case NAV_SURAH: {
        int surah = sel + 1;
        int ra = surah_resume_ayah(surah);
        float frac = khatm_surah_frac(surah);
        // Only ask when there's a distinct spot to resume to (partway read).
        if (ra > 1 && frac > 0.005f && frac < 0.995f) {
            s_resume_prompt = true;
            s_prompt_surah = surah;
            s_prompt_ayah = ra;
            s_prompt_sel = 0;
        } else {
            jump_to(surah, 1);
        }
        break;
    }
    case NAV_JUZ: {
        QRef r = qdb_juz_start(sel + 1);
        jump_to(r.surah, r.ayah);
        break;
    }
    case NAV_PAGE: {
        QRef r = qdb_page_start(sel + 1);
        jump_to(r.surah, r.ayah);
        break;
    }
    case NAV_BOOKMARKS: {
        Bookmark b = progress_bookmark(sel);
        jump_to(b.surah, b.ayah);
        break;
    }
    default: break;
    }
}

static void back(void)
{
    if (s_mode == NAV_ROOT) scene_switch(SCENE_HOME);
    else s_mode = NAV_ROOT;
}

static void on_enter(void) { s_mode = NAV_ROOT; s_resume_prompt = false; }

static void on_input(InputEvent e)
{
    if (s_resume_prompt) {
        switch (e.type) {
        case INPUT_NAV_UP:   case INPUT_ENC_CCW: s_prompt_sel = 0; break;
        case INPUT_NAV_DOWN: case INPUT_ENC_CW:  s_prompt_sel = 1; break;
        case INPUT_NAV_SELECT:
        case INPUT_ENC_PUSH: {
            int ayah = s_prompt_sel == 0 ? s_prompt_ayah : 1;
            s_resume_prompt = false;
            jump_to(s_prompt_surah, ayah);
            break;
        }
        case INPUT_BTN_BACK:
        case INPUT_BTN_MENU: s_resume_prompt = false; break;
        default: break;
        }
        return;
    }
    switch (e.type) {
    case INPUT_NAV_UP:
    case INPUT_ENC_CCW:  move(-1); break;
    case INPUT_NAV_DOWN:
    case INPUT_ENC_CW:   move(+1); break;
    case INPUT_NAV_SELECT:
    case INPUT_ENC_PUSH: enter(); break;
    case INPUT_BTN_BACK: back(); break;
    case INPUT_BTN_MENU: scene_switch(SCENE_HOME); break;
    default: break;
    }
}

static const SceneCallbacks CB = {
    .on_enter = on_enter,
    .on_render = on_render,
    .on_input = on_input,
};

void scene_nav_register(void) { scene_register(SCENE_NAV, &CB); }
