ibpasha1/QuranNode/(commit log)

2026-09-04 Initial commit: QuranNode — distraction-free Quran reader
    Portable C99 core + swappable HAL (SDL sim / ESP32-S3 firmware), offline
    pre-shaped Arabic glyphs, per-ayah recitation, and a GitHub-Releases OTA
    update path (Settings > Update firmware / hold-center recovery).
    [lid.step, lid.stl, partitions.csv, qurannode_enclosure.FCStd, qurannode_enclosure.step, tray.step, tray.stl]
2026-09-04 Add GitHub Actions release pipeline for OTA firmware
    Push a v* tag -> CI builds firmware.bin (Wi-Fi creds from repo secrets,
    assets regenerated) and publishes a Release the devices pull. Commit the
    Al-Fatihah recitation so CI can bake the no-SD fallback.
2026-09-04 Pin espressif32@6.4.0 (IDF 5.1.1) so CI matches local
    Newer IDF split the `driver` component, breaking driver/uart.h + i2s_std.h
    includes in CI. Pinning to the local platform version fixes the release build.
2026-09-04 Auto-update on boot from GitHub Releases
    On boot the device connects Wi-Fi, compares the latest release's version.txt
    to its own FW_VERSION, and installs a newer image before starting (skips
    instantly if offline or up to date). CI now publishes version.txt and stamps
    the image version from the git tag.
    [dump_frame.c, hal_sim.c, main.c, ota_esp32.c]
2026-09-05 UI overhaul: launcher home, mushaf theme, live keybar, prayer times, clicks
    - New emerald+gold+ivory "mushaf" palette replacing the cyan terminal look
    - Home is now a launcher: hero continue-reading widget (juz badge, ayah
    progress bar, illuminated double-rule frame), live next-prayer strip,
    and the app list (Quran / Lessons / Quran Teacher / Practice / Library /
    Settings; unbuilt modes shown with a SOON badge + toast)
    - theme_keybar: interactive bottom button guide — chips show what each
    physical key does in the CURRENT state and flash gold when pressed
    - Real prayer times: core/quran/prayer.c (ISNA angles, Shafi'i asr) fed by
    new hal_wall_clock()/hal_tz_offset_min(); location i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
2026-09-05 Fix OTA: enlarge HTTP buffers for GitHub CDN headers
    esp_https_ota + the version check failed with "HTTP_CLIENT: Out of buffer"
    because objects.githubusercontent.com sends large response headers that
    overflow the default 512B buffer. Bump buffer_size to 4096 for both the
    firmware download and version.txt fetch.
    [ota_esp32.c]
2026-09-05 Quran Teacher V1: listen -> recite -> analyze -> per-word review
    New SCENE_TEACHER practice loop: the teacher plays the ayah, the user
    recites into the mic, the recording is DTW-aligned to the reference and
    every word gets a verdict mark on the Arabic text — green underline =
    close match, amber = worth a listen, coral = significant mismatch or not
    heard. In review, words are selectable: OK plays the teacher's word, PL
    plays the user's matched segment, MD re-records the whole ayah.
    - core/audio/recite.c: 100ms acoustic features (log-RMS, ZCR, spectral
    tilt), per-utterance z-norm (cancels mic gain/voice brightness), full
    DTW with backtrack, per-word scoring + missing-word detection. V1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
    [audio_esp32.c, audio_sim.cpp, dump_frame.c, recite.c, recite.h, scene.c, scene.h]
2026-09-05 Per-surah glyph packs + Juz Amma content on SD
    Packs are now per-surah (packs/reader_<size>[_tj]/<surah>.qgp); the reader and
    teacher load only the current surah, so RAM stays bounded. shape_quran.py takes
    --surahs/--outdir; fetch_sample.py pulls whole surahs (Juz Amma 78-114). Reader
    surah name now comes from the DB. SD content (packs/audio) is gitignored and
    lives on the card; the committed emb_*.c holds the no-SD Al-Fatihah fallback,
    so CI builds firmware with no asset generation.
2026-09-05 Hold-to-scroll nav + fix audio glitch on pause/leave
    5-way directions now auto-repeat (accelerating) when held, so long lists like
    the 114-surah picker scroll fast. The audio task now feeds silence to I2S when
    not playing, instead of letting the DMA loop the last PCM buffer — kills the
    buzz on pause and when leaving the reader. Also fixed the stale SD boot check
    to look at per-surah paths.
    [audio_esp32.c, hal_esp32.c]
2026-09-05 Implement INMP441 I2S microphone capture
    hal_mic_start/read/stop were stubbed (return false), so the Quran Teacher
    reported "no microphone". Now brings up an I2S RX channel on I2S_NUM_1
    (SCK7/WS8/SD9), reads the 24-bit-in-32-bit INMP441 samples, and scales to
    int16. Gain shift (>>13) and left/right slot may need tuning per board.
2026-09-05 Teacher: voice endpointing — trim silence, auto-stop, fix false "not heard"
    Field bugs from first live use:
    - "not heard - try again" on words the user DID recite: recording starts
    the instant the teacher's audio ends, so the take begins with silence
    while the user draws breath; DTW aligned that lead-in to the first
    word(s). Analysis now trims to the voiced span (250ms preroll, 330ms
    tail) via a peak-based voice endpointer.
    - Scoring also skewed by silence at the z-norm level: silence frames are
    ~-100dB outliers, so each side's normalization shifted by how much
    silence it happened to contain — identical voice scored as different.
    Stats now come from voiced frames only, z-va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
    [dump_frame.c, recite.c, scene_teacher.c]
2026-09-05 Teacher: self-calibrating verdicts — stop flagging correct recitation
    Live feedback: real voice against the reference reciter scored "unsure /
    not heard" wholesale. Three fixes in the scorer:
    - Verdicts are now RELATIVE to the take: graded against the lower-
    quartile word score (your best-matched words set the bar) instead of
    absolute thresholds a learner's voice can never meet. Absolute floors
    keep identical audio GOOD; ceilings keep wholesale divergence from
    self-normalizing into a pass.
    - Pause frames (breathing between words) are excluded from word scores —
    pausing isn't a mismatch — and the voiced floor uses the 95th
    percentile, not the max, so one loud syllable no lo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
    [recite.c, scene_teacher.c]
2026-09-05 Release v0.6.10: teacher verdict calibration + fetch fix
    Ships the Teacher self-calibrating verdicts (652fee8) and a fetch_sample.py
    fix: word-timing segments sometimes return [start,end] (2 fields) not
    [word,start,end] (3) — take the last two, and skip a bad surah instead of
    aborting the whole download.
    [fetch_sample.py]
2026-09-06 Teacher: fix mic sample rate — the actual "not heard" root cause
    hal_mic_start opened the SDL capture device with ALLOW_FREQUENCY_CHANGE,
    so macOS delivered its native 44.1/48kHz stream while everything
    downstream assumed 16kHz. Time ran ~3x fast internally: the silence
    auto-stop fired after ~0.5s of real silence (cutting recitation off
    mid-word), the buffer cap hit at ~13s, and the analysis timeline was
    stretched 3x — words mapped to the wrong audio and scored "not heard"
    regardless of the recitation. allowed_changes=0 makes SDL resample to
    16kHz for us.
    Verified with an acoustic loopback: played the real reference recitation
    through the speakers, recorded it through the mic (real room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
    [audio_sim.cpp, scene_teacher.c]
2026-09-06 Release v0.6.11: Quran Teacher mic sample-rate fix
    Ships d843592 — corrects the mic sample rate, the real root cause of the
    teacher's "not heard" behaviour.
2026-09-06 Teacher: noise-relative voiced floor — fix "word 1 not heard" (mic AGC)
    The persistent "Word 1: not heard" came from mic auto-gain: macOS ramps
    capture gain up over the first ~second, so the opening word records
    20dB+ quieter than the rest of the take. Both silence tests measured
    "voiced" relative to the VOICE level (median/p95-based floors), so a
    quiet-but-present first word read as silence.
    - recite.c: voiced floor is now noise-relative — the take's 5th
    percentile (the room) + 8dB, capped 12dB under the p95 voice level for
    takes with no silence. A word is "not heard" only if its audio sits at
    room-noise level, regardless of how quiet the AGC made it. Also added
    a temporal miss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
    [recite.c, scene_teacher.c]
2026-09-06 ESP32: implement reference PCM readback + user-recording playback
    The device teacher log showed the last gap: analyze ran with ref=0ms@0 —
    hal_audio_read_pcm16 was still the no-mic-era stub, so with no reference
    to compare against every word was force-marked "not heard" regardless of
    the (working, INMP441) recording.
    - hal_audio_read_pcm16: full minimp3 decode of the clip to mono s16 with
    a local decoder instance (playback state untouched; clip bytes only
    read). Runs on qn_main, whose 40KB stack already budgets minimp3's
    ~18KB decode scratch.
    - hal_pcm_play/stop/is_playing: "hear yourself" playback — the audio
    task pumps the mono recording nearest-neighbor upsampled to 44.1k
    s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
2026-09-06 Release v0.6.12: teacher works on-device — reference decode + AGC fixes
    Ships e1b497f (ESP32 hal_audio_read_pcm16 + hal_pcm_play — the device
    teacher was comparing against zero reference samples, so every word
    scored "not heard") and 1e19e1f (noise-relative voiced floor for mic
    auto-gain quiet first words).
2026-09-06 Release v0.6.13: teacher — connected speech isn't "not heard" + clear result panel
    Field result on-device was 3-of-4 green but the panel read "not heard -
    try again". Two fixes:
    - recite.c: drop the duration-based missing check. Connected recitation
    ("alhamdu-lillahi") blends words, and a fast take squeezes a word to a
    sliver of voiced audio — merged delivery, not a skip. A word is now
    "not heard" only when its aligned span is mostly actual silence. V1
    prefers missing a real skip over flagging correct recitation.
    - Review panel: the overall result headlines ("MashaAllah - all matched"
    / "3/4 matched - review"); the selected word's verdict is scoped as
    "word N: ..." below it.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
    [recite.c, scene_teacher.c]
2026-09-06 Release v0.6.14: teacher — calibrate on field data, drop INMP441 start thump
    The user recited deliberate gibberish and most words still scored green.
    Their device logs provided the first real calibration data:
    - Verdict ceilings tightened to the observed separation line: genuine
    words scored <=1.9 against the reference, gibberish mostly >=2.0.
    Ceilings 2.6/3.2 -> 1.95/2.55, so wrong-content words now mostly flag
    (the logged gibberish take grades 1 good / 2 unsure / 1 missing
    instead of 3 green). Same-rhythm wrong words can still slip through —
    the honest V1 limit; reliable wrong-word detection is the V2 phoneme
    model.
    - Every device take logged voiced=[0..] — the INMP441's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
    [recite.c, scene_teacher.c]
2026-09-06 Release v0.6.15: teacher hears content — MFCC features replace envelope set
    Second field gibberish test scored 1.4-1.7 — inside genuine range. With
    envelope-level features (energy/ZCR/band ratios), wrong words recited
    with the reference's cadence are indistinguishable from real recitation;
    threshold tuning was exhausted (tighter = re-flagging honest takes).
    Features are now 12 MFCCs (1024-pt FFT, 20-band mel filterbank 100Hz-
    7kHz, DCT-II, c0 dropped) + log-energy + ZCR, computed on a 64ms Hann
    window per 100ms frame, any input rate gathered to 16k. The existing
    voiced-only z-norm doubles as cepstral mean/variance normalization
    (cancels mic/channel coloring). Distance renormalized by di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
    [recite.c]
2026-09-06 Release v0.6.16: teacher — 40ms frames so DTW matches phonetic trajectories
    At 100ms a word was 3-8 frames of averaged spectrum, and compressed
    same-voice mumble could cherry-pick a charitable DTW alignment. At 40ms
    (32ms/512-pt analysis window) a word spans 15-25 frames and the path
    must track the consonant-vowel sequence through it.
    Real-audio adversarial proof (acoustic loopback, same reciter voice):
    correct ayah vs its reference = all GOOD at 0.97-1.09; a DIFFERENT ayah
    vs that reference = word 1 MISSING (3.39), word 2 UNSURE (1.98) — wrong
    content in a consistent voice now separates cleanly. Synthetic battery
    unchanged: identical 0.00, garbled all flagged, learner/AGC green,
    omissi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
    [recite.c, scene_teacher.c]
2026-09-06 Release v0.6.17: teacher — refuse to grade fragment takes
    Field log: a 0.7s grunt against a 5.4s ayah scored 3 green — DTW crammed
    three reference words onto overlapping 100ms slivers of the same burst
    (word spans [500..600] twice). A take that fragmentary can't be judged
    word-by-word, and green is the wrong answer to it.
    Coverage gate: voiced take under 1/4 of the reference duration (or under
    1.2s absolute) returns to READY with "Too short - recite the whole ayah"
    instead of grading. Abdul Basit's murattal is slow, so genuine fast
    recitation (field takes: 37-80% coverage) clears the gate comfortably.
    Note the same session's full-length gibberish take WAS caught by the
    40ms engine: 2.7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
    [scene_teacher.c]
2026-09-06 Release v0.6.18: teacher engine v2 — delta-MFCCs, constrained DTW, gray verdict
    Implements the tuning roadmap from the user's design notes ahead of the
    labeled-sample calibration session:
    - Features 14 -> 37 dims: 12 MFCCs + delta + delta-delta (consonant
    transitions carry the articulation) + log-energy. ZCR dropped.
    - Normalization: cepstral MEAN per side, but per-dim SCALE from the
    reference only — full per-side variance normalization made a monotone
    mumble look as spectrally lively as the reciter (notes item 5).
    - DTW constrained: Sakoe-Chiba band (~1.2s) + slope-limited steps
    {(1,1),(1,2),(2,1)} keep local warp within 0.5-2x, with step penalties
    — the aligner can now FAI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
    [dump_frame.c, recite.c, recite.h, scene_teacher.c]
2026-09-06 Release v0.6.19: teacher TRAIN mode — rapid labeled-take capture for tuning
    Practice flow is too slow for dataset collection (listen, recite, wait
    for analysis, review, retry). New training capture mode: from the
    teacher's READY screen, MD enters a scripted 20-take session — 5x
    sincere, 5x sincere-fast, 5x gibberish, 3x skip-word-2, 2x wrong-ayah.
    Each take: OK, recite, pause — the recording is written straight to the
    SD card as a labeled 16k mono WAV (state/train_NN_label.wav, untrimmed
    so offline tuning can re-run endpointing too) with NO analysis, and the
    next prompt appears. ^v skips/redoes takes; BK exits.
    tools/recite_eval.c (make recite-eval): host-side batch evaluator that
    rep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
    [recite_eval.c, scene_teacher.c]
2026-09-06 Release v0.6.20: teacher — every action reachable from the 5-way alone
    The device's only physical control is the 5-way switch; MODE/PLAY/
    BOOKMARK exist only as serial-monitor keys (Tab/Space/k). The teacher
    bound TRAIN to MODE and hear-yourself/retry to PLAY/MODE — unreachable
    on the standalone device (field question: "whats MD, is that a button?").
    - READY: RIGHT enters TRAIN mode (chip "> TRAIN"); MODE still works.
    - REVIEW: UP = hear yourself, DOWN = retry (chips "^ YOU" / "v RETRY");
    PLAY/MODE still work from the sim/serial.
2026-09-06 Release v0.6.21: robust training saves — SD retry, chunked writes, no lost takes
    Field session hit a transient SD write error on take 5 of 20 (sdmmc
    r2=0x2000 mid multi-block DMA burst) and the trainer aborted the whole
    session.
    - hal_esp32 state_save: 16KB chunked writes with a breather between
    chunks (short bursts instead of one 100-300KB DMA run); a failed write
    removes the partial file so retries start clean.
    - Trainer: 3 write attempts per take; on persistent failure the session
    STAYS on the same take with "Save failed - OK to re-record" instead of
    aborting — takes 1-4 on the card stay valid either way.
    [hal_esp32.c, scene_teacher.c]
2026-09-06 Release v0.6.22: training takes in RAM + Wi-Fi download — route around the SD
    The SD failures aren't transient: field log shows overwrites of existing
    files succeed while fresh-cluster allocations fail persistently
    (r2=0x2000 write / r2=0x0200 erase, all retries) — the signature of a
    failing or counterfeit-capacity card region. Retry loops can't fix dead
    sectors, so the takes now bypass the card entirely:
    - Every training take is kept in PSRAM (~100KB each, 20 takes fit
    comfortably in the 4MB free) regardless of the SD outcome; an SD
    failure no longer interrupts the session at all.
    - LEFT on the training screen starts Wi-Fi sharing: the OTA web server
    gains /takes (HTML index) + /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
    [dump_frame.c, hal_sim.c, ota_esp32.c, scene_teacher.c]
2026-09-06 Release v0.6.23: fix unreachable /takes — share from READY, don't exit on done
    Field report: http://<ip>/takes unreachable. Two flow bugs made the
    share option effectively impossible to use:
    - Completing take 20 dropped back to READY, where LEFT (wifi share) was
    not bound — the trainer now STAYS on its screen ("All 20 done! < =
    wifi download").
    - Leaving the teacher scene frees the RAM takes, so navigating anywhere
    killed the data before it could be served. LEFT now also works from
    READY (shares whatever is still in RAM; hints if nothing is).
    READY shows the download URL while sharing. Note for the field: the URL
    in the boot banner dies when the auto-update check finishes — o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
    [scene_teacher.c]
2026-09-06 Release v0.6.24: tempo-normalized alignment — first real-dataset findings
    First labeled device takes (7 WAVs pulled over the new /takes Wi-Fi
    path) immediately exposed a structural bug: the user recites 2.5-3.5x
    faster than the murattal reference, which the slope-limited DTW (max 2x
    local warp) cannot align — every real take scored "couldn't judge".
    - recite.c: GLOBAL tempo normalization — the user's frame sequence is
    resampled to the reference length before DTW (map[] keeps reported
    spans on the recording's real timeline); slope limits now govern only
    local deviations, as intended. Overall pace is not an error.
    - Coverage gate: absolute floor only (<900ms). A fluent full take c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
    [recite.c, recite_eval.c, scene_teacher.c]
2026-09-06 docs: Quran Teacher V2 spec — cloud/LAN phoneme scoring
    Architecture, model choice (tarteel-ai/whisper-base-ar-quran, 5.75% WER
    on Quranic recitation), server API (FastAPI, CSV response for trivial
    ESP32 parsing), transcript-to-canonical-text alignment + verdict
    mapping, device HAL protocol with offline fallback to the V1 engine,
    privacy stance (LAN Mac by default), and milestones — M1 is a server MVP
    gated on benchmarking against the labeled take dataset before any device
    work begins.
2026-09-06 docs: V2 spec — productization sizing (Pi 5 cluster, self-hosted scoring)
    Stateless-node scaling math (Pi 5 ≈ 5-10 concurrent practicing users;
    4-Pi cluster ≈ hundreds of registered users), perf/$ alternatives, and
    the product-grade requirements: TLS + device tokens, process-and-delete
    audio policy, rate limiting, and the offline fallback as resilience.
2026-09-06 V2 M1: scoring server core + first benchmark against labeled takes
    server/score.py: tarteel-ai/whisper-base-ar-quran transcription, Arabic
    normalization, word-level Needleman-Wunsch alignment vs canonical text
    (server/quran_text.json, surah 1), verdict mapping per docs/TEACHER_V2.md.
    Capture cleanup baked in: 90Hz high-pass (spectral forensics showed the
    INMP441 field takes carry 0-100Hz rumble AS LOUD AS THE VOICE — it wrecks
    the mel features) + peak normalization. server/eval.py: labeled-dataset
    benchmark with acceptance gates.
    M1 benchmark results:
    - bad/gibberish takes: 100% flagged (gate: >=75%) PASS
    - wrong-ayah: 100% flagged PASS
    - latency: 0.3-3.2s/take PASS
    - sincere takes: FAIL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
2026-09-06 V2 M1 PASSES with whisper-large-v3-turbo — model was the bottleneck
    Close-mic deliberate takes under the recitation-tuned base model still
    scored ~15% words correct; the same WAVs under openai/whisper-large-v3-
    turbo: takes 3+5 transcribe PERFECTLY (4/4 "الحمد لله رب العالمين"),
    75-100% words GOOD across the set. The murattal-tuned model collapses on
    casual-pace speech — match the model to the user's delivery, not the
    reference's.
    Counter-checks hold: deliberately-bad takes keep their flags (and the
    model precisely credits the real words they started with), wrong-ayah
    100% flagged, ~4s/take on M-series CPU. Default model switched; base
    stays available via QN_ASR_MODEL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
2026-09-06 Release v0.6.25: V2 M2 — the device scores recitation CONTENT online
    The teacher now asks the scoring server (server/app.py, FastAPI wrapping
    the whisper-large-v3-turbo pipeline validated in M1) for word-level
    verdicts: the take is POSTed as WAV, the server transcribes it and
    compares words against the canonical ayah text, and its verdicts replace
    the local acoustic estimates. Voice/style/pace drop out of the judgement
    entirely. Offline or server-down -> the local V1 engine stands, and the
    review panel says which one you got ("scored by teacher server" /
    "similarity only - offline estimate").
    - hal_score_remote: ESP32 via esp_http_client (TEACHER_URL from
    secrets.ini, CI passes it throu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
    [audio_esp32.c, dump_frame.c, hal_sim.c, ota_esp32.c, scene_teacher.c]
2026-09-06 Release v0.6.26: fix mic distortion — gain headroom + clip counter
    The user listened to the training WAVs: audibly distorted. Root cause:
    the INMP441 conversion applied +18dB digital gain (>>13) and the old
    cast WRAPPED past full scale instead of clipping — every loud syllable
    was garbled in all captured takes (and fed to both scoring engines).
    Gain is now >>14 (+12dB, close-mic speech peaks land ~0.3 fs with clean
    headroom; digital gain never changed the SNR, only the clipping), the
    HPF path saturates, and a per-take clipped-sample counter logs a warning
    so gain problems are visible in the field instead of discovered by ear.
    [audio_esp32.c]
2026-09-07 Release v0.6.27: perceptual volume curve — the slider audibly works
    Field report with the speaker wired: lowering volume in Settings "doesn't
    actually lower the volume". The mapping was linear (100% -> 2.0x, 50% ->
    1.0x): halving amplitude is only -6dB, barely perceptible — and at high
    gain the peaks clip to the same loudness regardless, so most of the
    slider's travel did nothing audible.
    prefs_volume_gain(): cubic taper (100% -> 2.0x, 50% -> 0.25x, 20% ->
    0.016x, 0% -> mute), used by both prefs_apply and the live Settings
    slider. Every 5% step is now audible.
    [prefs.c, prefs.h, scene_settings.c]
2026-09-08 Reader: scroll tall ayat + I2S follows each file's real sample rate
    Two audio/display fixes surfaced while loading the full Quran onto SD:
    1. Al-Baqarah played at 2x speed. Its source (quranicaudio.com) is
    genuinely 22.05kHz while every other surah is 44.1kHz, and the ESP32
    HAL clocked I2S at a fixed 44100 with no resampling. Now set_out_rate()
    retunes the I2S clock to the decoded frame's rate (disable -> reconfig
    -> enable), only when it actually changes so steady 44.1k never glitches;
    the user-recording pump forces 44.1k back. hal_audio_open no longer
    pre-seeds c->hz, so pos_ms uses the true rate and word-sync stays aligned.
    2. ~43% of ayat at Large are taller than the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
    [audio_esp32.c, scene_reader.c]
2026-09-08 Settings: animated firmware-update overlay
    Replace the static single-line update screen with a phase-driven animated
    overlay (inferred from the HAL status string, driven off plat_millis):
    orbiting gold comet on a sonar ring, per-phase centre glyph (sequential
    Wi-Fi arcs / download-into-tray with falling particles / green check / red
    X), breathing status ellipsis, and an indeterminate scanner bar. Sim OTA
    stub now fakes a connect->download->done progression so the animation can
    be seen end-to-end in the simulator.
    [hal_sim.c, scene_settings.c]
2026-09-08 Khatm tracking: read coverage in mushaf pages, daily pace, finish-by date
    The device knew one thing about your reading: a resume point. It could not
    say how much Quran you had read, how much today, whether you were on pace,
    or what to read next — and nothing could be highlighted as already read.
    Adds core/quran/khatm.c + a Progress scene built on four decisions:
    - Pages, not ayat. The Madani 604 is what people actually say. Tracked in
    milli-pages so partials are exact; per-ayah credit is DIFFERENCED, since
    adding 1000/n per ayah drifts (1000/42*42 = 966) and never reaches 604.0.
    New PAGE_FIRST/SURAH_FIRST tables generated into quran_db (~1.8KB flash).
    - Dwell-based crediting. An a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
    [app.c, build_db.py, hal_esp32.c, hal_sim.c, khatm.c, khatm.h, khatm_test.c]
2026-09-08 Tajweed: corrected rule palette + derived tafkhim; regen lg pack
    shape_quran.py now maps rule names exactly (the *_mutajanisayn /
    *_mutaqaribayn spellings were wrong and fell through to uncolored),
    groups colours by pronunciation (ghunnah family green, silent/merged
    grey), and derives tafkhim (heavy laam of Allah + heavy raa) straight
    from the Uthmani text. Regenerated emb_qn_pack_lg_tj.c to match.
    [shape_quran.py]
2026-09-08 Nav accel: ramp harder (to 32x) and widen hold gap to 600ms
    A sustained hold now sweeps a long list (114 surahs) in a second or two
    instead of crawling. Gap widened to 600ms so the sim's slow host
    key-repeat still counts as a held streak rather than resetting each event.
    [input_accel.c, input_accel.h]
2026-09-08 Reader: resume-or-restart prompt + consistent per-surah % on home
    Two reading-progress fixes:
    1. Opening a partially-read surah from the surah list used to silently
    restart at ayah 1, ignoring that you were (say) 8% through. Now if a
    surah is partway read it asks "Resume N:M" vs "Start from beginning".
    "Resume" lands on the first unread ayah (khatm coverage), or the exact
    global last-position when that surah is the one you left off in — no new
    durable storage, so it sidesteps the ProgressBlob-growth wipe trap.
    2. The home "continue reading" hero showed the whole-mushaf % as a badge
    next to the surah name, so it read as a per-surah figure and disagreed
    with the surah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
    [scene_home.c, scene_nav.c]
2026-09-08 Shaper: add waqf (pause) marks to the reader text
    The glyph packs were shaped from the plain Tanzil Uthmani text, which has no
    waqf stop-signs, so the reader showed none. New pipeline:
    - build_waqf_text.py pulls the waqf marks from quran.com's Uthmani script and
    injects ONLY those mark codepoints into our exact text (letters untouched),
    clinging to the preceding word. It never inserts spaces, so the word count —
    which drives per-word recitation timing/highlight — is unchanged. It then
    remaps the cpfair tajweed annotation offsets across the inserted marks.
    - shape_quran.py gains --text-file/--annot-file to shape from that variant.
    - build_packs.sh regenerates all 5 sizes x plain/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
2026-09-08 Hifz engine: sabaq/sabqi/manzil scheduler + one authoritative word index
    Groundwork for Lessons. No UI yet — this is the model, proven headlessly before
    900 lines of drill land on top of it.
    The scheduling unit is a PORTION, not an ayah. You never review one ayah alone;
    the seam between ayat is the skill. Per-ayah state exists, but only as a
    strength signal for the heat map and weak-spot targeting.
    Sabaq and sabqi are date-driven; manzil is cycle-driven. That asymmetry is the
    design. "Manzil" names the seven-part division used to finish the Quran in a
    week: the classical rule is that nothing memorized goes much more than seven
    days unseen, and the daily load is capped by TIME, not by an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
2026-09-08 Lessons: today's sabaq/sabqi/manzil plan, gradeable by hand
    Wires the hifz engine to a screen. Home's "Lessons" row stops saying SOON.
    The dashboard's job is to say what to do today, in what order, and to refuse
    politely when new material would be a mistake. Pick a target (juz or surah,
    learn-forwards or learn-backwards), and it carves the day's new portion, lists
    what review is due, and takes a grade on each.
    Grading straight from the list is a first-class path, not a fallback. The drill
    will be a better way to earn a grade, but a hafiz reviewing from memory on a
    walk should just be able to tap — so the grade sheet leads with "grade it from
    memory, not from the page", which is the whole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
    [hifz.c, khatm.c, scene.c, scene.h, scene_hifz.c, scene_home.c]
2026-09-08 Player: observable loop_done_seq for finite-loop completion
    Loop completion was unobservable without a race: playing stays true
    through queue_ayah's inter-clip pause, so a poller can't distinguish
    "done" from "between clips". Tick loop_done_seq once when a finite
    loop finishes; the hifz drill (H3) uses it to leave LISTEN/ECHO.
    loop-test now asserts the seq ticks exactly once.
2026-09-08 Arabic: progressive veil as a post-pass over word boxes
    The drill hides words to test recall. Threading a mask through the
    glyph blit would need a per-pixel "which word owns this?" test, but
    word boxes overlap and don't tile (~1.3M tests/frame). Instead draw
    the ayah normally, then paint a curtain over the hidden words' boxes:
    O(n_hidden) rects, and it works with the plain AND tajweed blit for
    free since it never touches the coverage.
    Hiding is deterministic, never random — VEIL_TAIL keeps the opening as
    the retrieval cue and hides the ending (33->66->100%), with a box
    outline during FADE (word shape is a legit scaffold) and none at
    RECALL. ayah_word_span_box frames a whole segment. pad=2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
2026-09-08 Hifz drill: talqeen phase machine (LISTEN->ECHO->FADE->RECALL)
    The drill for one memorization sitting. The dashboard chunks a portion
    into word-range segments; this engine walks each through hear/echo/
    recall-under-a-veil, then stitches segments with a SLIDING connect
    window and one full-chunk run. Load-bearing rules, all pinned by
    make hifz-drill-test (virtual-clip harness, like loop-test):
    * The connect window slides [max(0,k-2)..k], it never restarts from
    segment 0 — restarting is what breeds strong openings and weak
    middles. Every seam is practised twice, every segment equally.
    * A grade is only taken from a hidden state: ASSESS is reachable only
    out of RECALL. NO re-loops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
2026-09-08 Lessons: wire the drill scene in; OK drills, LEFT hand-grades
    scene_hifz_drill renders the drill engine's phases: the framed segment
    with the progressive veil painted over the word boxes, the timed-rep
    countdown, and the GOT/SHAKY/NO grade block reused from the dashboard.
    It forces packs/reader_sm regardless of the reader's font size (a
    recall you can only see a third of can't be self-assessed) and falls
    back to the user's pack only if the small one is absent. On completion
    it applies one portion grade — hifz_grade already cascades that to
    per-ayah strength.
    The dashboard now opens the drill on OK (the better way to earn a
    grade) and keeps hand-grading on LEFT for reviewing from memory on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
2026-09-08 Word meanings: .qwm generator + streamed loader + font_wrap_lines
    Word-by-word English glosses for the drill's meaning sheet.
    tools/build_wordmeanings.py fetches per-word translations from the
    quran.com v4 API and reconciles them to the ONE authoritative word
    split this device draws and selects by (quran-uthmani.txt .split(' '),
    same as qdb_word_count) — never the timing split, which disagrees for
    12.2% of ayat. It filters the ayah-end rosette pseudo-word, prepends
    the four basmala glosses baked into ayah 1 of surahs 2-114 (except 9),
    and on any residual count mismatch emits EMPTY glosses + logs loudly
    rather than shifting (a misaligned gloss is worse than none).
    core/quran/wordmeaning.{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
    [build_wordmeanings.py, wordmeaning.c, wordmeaning.h, wordmeaning_test.c]
2026-09-08 Drill: word-by-word meaning sheet (MODE toggles, encoder scans)
    MODE / RIGHT opens a bottom sheet; the encoder walks the selected word
    across the current segment (flattened over its ayat), the Arabic word
    is highlighted in place, and its English gloss is shown wrapped with
    font_wrap_lines. The sheet pauses the drill so studying a word never
    burns the recall clock or auto-advances the phase.
    Glosses key to the glyph-pack word index (qdb_word_count / ayah_word_box),
    the same split .qwm is built against — so gloss N always sits under drawn
    word N. Opening the sheet reveals the text, so it records a peek (harmless
    in LISTEN/ECHO, honest during recall). With no .qwm on the card the sheet
    degra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
    [scene_hifz_drill.c]
2026-09-08 Mic: extract voice_activity endpointer + vad-test (pins it first)
    The recite auto-start/auto-stop endpointer lived inline in
    scene_teacher.c — VOICE_PEAK, preroll, tailpad, AUTO_STOP, NO_VOICE and
    the warmup drop, every one tuned against INMP441 field recordings, with
    zero test coverage. Before touching the teacher, lift it VERBATIM into
    core/audio/voice_activity.{c,h} (plus the WAV header helper) and pin the
    behaviour with make vad-test: warmup drops the DC-settle transient,
    voiced span with preroll/tailpad, auto-stop after 2.2s silence, give-up
    after 12s of nothing, full-buffer, and the analysis span.
    No behaviour change yet — the teacher refactor onto this module is the
    next (mechani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
2026-09-08 Power: idle backlight dim/blank + lower default brightness
    The backlight is the device's single biggest current draw (~110mA at
    full) and it burns continuously whenever the device sits untouched.
    - app.c: an idle manager dims the panel to ~25% after 75s and blanks it
    after 5min of no input. Any input restores it; active playback keeps
    it lit (follow-along reading). g_prefs.brightness stays the source of
    truth — only the panel duty is overridden, never the saved pref.
    - prefs.c: default brightness 90 -> 55 (legible, much easier on the cell).
    Roughly doubles screen-on reading runtime on the 1100mAh battery.
    [app.c, prefs.c]
2026-09-08 Teacher: delegate the mic endpointer to voice_activity
    Pure mechanical move — the inline warmup drop, peak detection, voiced
    span, auto-stop/no-voice logic and the local wav_header are replaced by
    va_feed / va_span / va_wav_header. Behaviour is unchanged and now pinned
    by vad-test (the test the teacher never had). ~60 lines of endpointer
    state and constants leave scene_teacher.c; s_va replaces s_heard/
    s_voice_a/s_voice_b/s_sil_ms/s_wait_ms/s_warmup_left.
    Verified: sim builds clean, all tests pass, teacher READY still renders.
    [scene_teacher.c]
2026-09-08 Drill: optional mic scoring — record -> analyze -> suggest
    During RECALL, UP records the recall into the mic. The shared
    voice_activity endpointer auto-stops on a pause, recite_analyze scores
    the take against the segment's reference recitation, and the result
    SUGGESTS a grade — it moves the ASSESS cursor onto a button; the user
    still presses OK. Nothing is ever auto-committed.
    Offline DTW only ever suggests DOWNWARD: its reliable signal is
    omission detection, not correctness, so gaps -> SHAKY, many gaps -> NO,
    and a clean-sounding take leaves the call to the reader. Fully optional
    and offline-safe: no mic, no reference audio, or low memory each just
    declines with a toast and the drill r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
    [scene_hifz_drill.c]
2026-09-08 Hifz: merge adjacent portions at the table cap instead of refusing
    The whole Quran at ~half a page a day is ~1200 portions, but the blob
    holds 480 (16 KB burst limit). Once material is consolidated, fine
    granularity stops paying its way — two adjacent solid same-tier portions
    review as one run. So when the table fills, hifz_start_new_portion now
    fuses the most-consolidated adjacent contiguous pair (prefer manzil, then
    highest box) to reclaim a slot, rather than silently returning -1 and
    stalling new material.
    The fused portion keeps the conservative schedule (weaker box, shorter
    streak, summed lapses, oldest created_day, soonest due) so a merge can
    only bring review sooner, never let a po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
    [hifz.c, hifz_test.c]
2026-09-08 Lessons: memorization heat map + weak-spot list
    Hold OK on the dashboard for a memorization map: the same 604-cell
    mushaf grid the khatm screen uses, but each page fills by memorized
    fraction (hifz_page_frac) and a page holding a lapsed ayah gets a coral
    cap so weak spots jump out. Below it, hifz_weak_ayat surfaces the
    weakest LEARNED-then-slipped ayat (lapsed first, then lowest strength —
    never still-unlearned material); OK on one drills the portion that
    covers it, turning the map into a review loop.
    New engine accessors: hifz_page_frac, hifz_page_has_weak,
    hifz_ayah_lapsed, hifz_weak_ayat. hifz-test pins them: a lapsed ayah
    flags its page weak and ranks first in the weak list.
    Also add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
    [dump_frame.c, hifz.c, hifz.h, hifz_test.c, scene_hifz.c]
2026-09-08 Hifz: waqf-aware chunking — split long ayat at pause marks
    When the chunker has to split an over-long ayah (2:282 is 128 words)
    into screen-sized segments, cutting at even word intervals lands
    mid-phrase. Now it cuts at waqf (pause) marks — where a reciter would
    actually stop — so each segment is a natural phrase.
    tools/build_waqf_db.py bakes core/quran/waqf.c from quran-uthmani-waqf.txt
    (purely local, no network): per ayah, the 0-based word indices with a
    pause after them, keyed to the same split as qdb_word_count. ~4400 marks,
    ~18 KB of flash read only when a long ayah splits. split_long_ayah picks
    the waqf boundary nearest the target size, still capping every segment at
    target*3/2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
2026-09-08 Drill: scroll + clip the band so tall segments don't collide with the label
    A short surah collapses into one whole-ayah segment (An-Nas is 6 ayat),
    which is taller than the reader band — the text stacked straight over the
    LISTEN/ECHO label and the lower ayat were unreachable.
    Now the band measures the segment (via a new blob-free glyphpack_dims,
    reading heights from the resident index) and scrolls teleprompter-style
    when it overflows: during audio LISTEN it follows the playing ayah, with
    the meaning sheet open it follows the selected ayah, and on a timed rep
    it pans top->bottom at recite tempo so every ayah comes into view. Ayat
    fully outside the band are culled, and the strips above and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
    [arabic_text.c, arabic_text.h, hifz_drill.c, hifz_drill.h, scene_hifz_drill.c]
2026-09-09 Reader: end-of-ayah numbered medallion (۝ + ayah number)
    Adds the mushaf end-of-ayah rosette with the ayah number enclosed, alongside
    the waqf marks.
    - build_waqf_text.py appends U+06DD + the Arabic-Indic ayah number to each
    ayah, with NO leading space so the word count (recitation timing) is
    unchanged, and after every annotated letter so tajweed offsets are untouched.
    - shape_quran.py: AmiriQuran encloses the number by emitting the digits as
    ZERO-advance glyphs *before* the rosette base, with an x_offset measured from
    the pen AFTER the rosette advances. Our forward pen placed them to the left
    (outside). Fix: a leading run of zero-advance glyphs — which only occurs for
    the ve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
    [build_waqf_text.py, shape_quran.py]
2026-09-10 Recite (read-along) mode + live score-follower + audio-highlight latency fix
    Reframe the Quran Teacher as "Recite", a voice-following read-along (grading
    retired — V1 acoustic scoring can't grade a learner vs the reciter):
    - Live score-follower engine (recite_live_* in recite.c): online, tempo-free
    DTW that tracks the reciter's voice per ayah; forward-biased FOLLOW mode with
    a pace-learning floor so it can't stall on weak cross-voice audio.
    - Recite scene: in-mode surah/range/turn-size picker (front door), trade-off
    loop (repeat-after / take-turns), per-ayah and per-page turns with a seamless
    page read-through, live word highlight + auto-scroll + green "read" trail.
    - Fix a latent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
    [audio_sim.cpp, dump_frame.c, hifz_drill_test.c, loop_test.c, player.c, recite.c]
2026-09-10 shape_quran: size glyph bitmaps to real vertical ink (fix clipped vowels)
    The rasterizer sized each line to the font's metric line height (+4px pad) but
    placed glyphs by real ink, so marks whose ink rises above the ascender —
    dagger/superscript alif, shadda-stacks, high sukun — had their tops clipped,
    dropping vowels (worse at large sizes: the 4px pad doesn't scale). Now the
    bitmap covers the real vertical ink extent, exactly like the horizontal bounds
    already did. Backward-compatible: byte-identical for lines that don't overshoot;
    only previously-clipped ayat grow. Verified at xxl: 3/7 of al-Fatihah's ayat
    were clipped (+6..8px recovered). Packs must be regenerated (tools/build_packs.sh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
    [shape_quran.py]
2026-09-10 Perf: precompute recite DSP tables, band DTW init, cache hifz map, binary-search glyph index
    Four behavior-preserving optimizations to the heaviest CPU paths, all verified
    to produce identical results:
    - recite.c: bake the Hann window + DCT-II basis into tables in mel_init instead
    of recomputing ~750 cosf per frame (~750k soft-float calls per scoring run on
    the ESP32). extract_frame now does table lookups.
    - recite.c: INF-init only the Sakoe-Chiba band (+1-cell border) of the DTW cost
    matrix, fused into the compute loop, instead of the full rn*un_n matrix
    (~220k fewer writes/run). Differential-tested bit-identical to HEAD (the sole
    1-ULP delta is FMA contraction, confirmed via -ff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
2026-09-10 st7796s: harden cold-boot init against clipped-bottom display bug
    Intermittent (~4/5 cold boots) the panel rendered ~90% with the bottom strip
    cut off, cured by a warm reboot — the signature of config commands failing to
    latch while the supply/charge-pump is still ramping (display init runs very
    early in boot; no MISO wired so we can't read back to verify/retry). Preventive
    hardening: settle 120ms before touching the panel, longer reset/sleep-out wake
    margins, and small delays after the cmd-2 unlock and the 0xB6 display-function
    control (whose 0x3B sets NL=480 lines — the likely culprit for the bottom strip).
    FW_VERSION -> v0.6.29. Needs on-device testing (can't reproduce a HW timing rac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
    [st7796s.c]
2026-09-10 Idle dimmer: stay lit during any audio playback or mic capture
    The backlight dimmer only treated g_player.playing as "active", so it dimmed
    mid-recitation in the Recite read-along (plays via its own clip) and Library
    media, and during a recite "your turn" (mic capturing) — none of which go
    through the main player. Add clip-agnostic hal_audio_active() + hal_mic_active()
    and keep the screen lit when either is true. (A silently-read static page still
    dims — indistinguishable from having walked away.)
    Note: the esp32 impls of hal_audio_active/hal_mic_active are in audio_esp32.c,
    which is tangled with another instance's UI-click work and left uncommitted for
    now — the device build pulls th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
2026-09-10 Enclosure Rev F: shorter shell (184.8->156mm) + layout repack + PCB BOM
    Redesign to a shorter 156mm form factor with a slightly thicker shell,
    plus a series of fit refinements driven by measured hardware:
    - Shell: IH 180->151.2 (OL 156.0), INNER_D 13->15 (overall 17.8mm).
    Length reclaimed by rotating the battery landscape into the chin and
    stacking behind-screen parts in the extra depth.
    - Snap-fit: bigger nibs (10 x 2.0, 1.0mm projection) and 11 tabs (was 6)
    for a firmer close; positions retuned around the moved ports.
    - Screen: sized to a measured 55.6mm module (PCB == glass width); window
    54mm kept under the module so the inner lip actually retains it.
    - D-pad: integrated into th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
    [BOM.csv, lid.step, lid.stl, qurannode_enclosure.FCStd, qurannode_enclosure.step, tray.step, tray.stl]
2026-09-11 Tafsir Game: card generator + Leitner learner (engine + tests)
    New "learn the meaning of an ayah" lesson mode, built on the existing
    word-by-word .qwm glosses (no new data pipeline).
    - tafsirgame.{h,c}: pure, stateless card generator. Quiz / cloze / assemble
    cards from per-word glosses, with same-surah distractor sampling, graceful
    refusal on thin coverage, and an offset-keyed arena so cards survive copies.
    Copies every gloss on read since wordmeaning has a single cache slot.
    - tglearn.{h,c}: per-ayah Leitner scheduler + scope (surah/juz/quran, fwd or
    reverse). Dual-slot + CRC + append-only persistence copied from khatm/hifz,
    honest no-RTC degradation, frontier-based introduction,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
    [tafsir_test.c, tafsirgame.c, tafsirgame.h, tglearn.c, tglearn.h, tglearn_test.c]
2026-09-11 Tafsir Game: playable quiz scene (SCENE_TAFSIR_PLAY)
    The first on-screen slice of the meaning game. Walks tglearn's due queue
    (topped up with new ayat from the target), and for each draws the ayah with
    one word washed in gold and asks for its English meaning as a 4-way choice.
    Answering colours the correct/chosen rows and grades the ayah back into the
    Leitner scheduler (GOT/WRONG). Degrades to a "run build_wordmeanings.py"
    notice when an ayah has no glosses, matching the talqeen drill.
    - scene_tafsir_play.c: session build, highlighted-ayah + MCQ render, answer/
    feedback/next flow, graceful no-meaning + empty-target + done states.
    - scene.{h,c}: register SCENE_TAFSIR_PLAY.
    - app.c: tglearn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
    [app.c, dump_frame.c, scene.c, scene.h, scene_tafsir_play.c]
2026-09-11 Tafsir Game: cloze + assemble + per-ayah walk
    Each ayah is now a small deck instead of a single word: it walks a few of the
    ayah's words and rotates the three card kinds for variety, then grades the
    ayah by accuracy across the deck (all right -> GOT, a slip -> HARD, mostly
    wrong -> WRONG).
    - CLOZE: draws the ayah with the blanked word highlighted, the full English
    meaning with a "____" gap, and the same 4-way choice.
    - ASSEMBLE: shuffled meaning tiles picked into reading order with undo, then
    colored per-position feedback. Capped to short ayat (<=5 tiles) to stay
    legible; longer ayat rotate quiz/cloze only.
    - Kind rotation via a per-session spin; grade fed to tglearn per ayah.
    Verifi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
    [scene_tafsir_play.c]
2026-09-11 Tafsir Game: dashboard + scope picker, launched from Lessons
    Makes the meaning game reachable and configurable.
    - scene_tafsir.c (SCENE_TAFSIR): dashboard with the target hero, studied/
    mastered/due counters, a due-vs-new call to action and lifetime accuracy,
    plus a scope picker (surah / juz / whole Quran, forward or reverse) mirroring
    the memorization picker. OK plays a sitting (returns here on BACK); the picker
    sets the tglearn target.
    - scene_hifz.c: the Lessons screen's MODE button crosses over to the meaning
    game, with an "MD MEANING" keybar chip.
    - dump_frame.c: retire the temporary 'T' dev hook now that the real launch
    path exists (reverts it to its original state).
    Veri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
    [dump_frame.c, scene.c, scene.h, scene_hifz.c, scene_tafsir.c]
2026-09-11 Khatm: scoped goals — target a surah/juz/page-range, not just the whole Quran
    A goal is now "read this page window by this date"; whole-Quran is just the
    widest window (pages 1..604), so every existing save migrates untouched
    (scope packs into KhatmGoal.reserved, 0 = whole Quran).
    Core (khatm.c/.h):
    - Stats (quota/ETA/delta/completion) measured inside the window via new
    scope_* fields; the lifetime x/604 odometer and ETA stay whole-mushaf.
    - Plan clamps its walk to the window. Setters/resolvers: set_goal_pages,
    surah/juz_page_range, scope_read_mpages, scope_name. New khatm clears scope.
    Progress UI (scene_progress.c):
    - Goal editor gains a scope picker (Whole/Surah/Juz/Range) with a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
    [khatm.c, khatm.h, khatm_test.c, scene_progress.c]
2026-09-11 Home: name the goal scope in the daily cue; goal-aware foot line
    The Home hero foot now reads the active goal: "Al-Baqarah: 1.6 pg left ·
    on track" for a scoped goal, "Today: …" for whole-Quran, with dedicated
    lines for no-clock / complete / no-goal / overdue. Uses khatm_scope_name()
    so it matches the Progress card.
    Also carries two working-tree tweaks that were already staged here: the
    Lessons menu label "Quran Teacher" -> "Recite", and resume-into-reader
    taking its speed from the current Settings preference rather than the
    (stale) rate captured in the resume point.
2026-09-11 Reader/nav/audio polish: UI click sound + amp gating, highlight mapping, content-aware nav
    Snapshot of in-progress working-tree changes (already running on the device
    via the 21:24 OTA build) so a clean checkout / tagged release builds the same
    firmware. Three areas:
    - audio_esp32: mix a short decaying-sine UI click straight into I2S. The amp
    (PIN_AMP_EN) is off outside playback, so a click switches it on and holds it
    for a ~1.2s linger; a burst of menu taps pops the amp once instead of per-tap.
    - scene_reader: map the reciter's timing word index onto the drawn glyphs —
    skip the basmala prefix on ayah 1, sweep proportionally for the ~12% of ayat
    whose word splits disagree, and fre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
    [audio_esp32.c, scene_nav.c, scene_reader.c, scene_teacher.c]
2026-09-11 Release v0.6.30: scoped khatm goals + Tafsir Game + reader/nav/audio polish
    Bumps FW_VERSION to v0.6.30 so the tagged release build and the device's
    update check line up.
2026-09-11 Tafsir Game: add a Home "Meanings" tile; reach it from any Lessons mode
    The meaning game was only reachable via the Lessons MODE button, and that
    chip/handler lived only in the plan (VIEW) mode — so a user with no
    memorization target set (who lands on the target picker) had no way in, and
    even with a target it was easy to miss.
    - scene_home.c: first-class "Meanings" tile in the app list -> SCENE_TAFSIR.
    - scene_hifz.c: handle MODE globally so the cross-over works from any Lessons
    mode, including the first-run target picker.
    - scene_tafsir.c: dashboard BACK returns to Home (it's now a top-level entry),
    predictable regardless of how it was opened.
    Verified Home -> Meanings -> picker vi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
2026-09-11 Tafsir Game: fix wordmeanings fetch (403) and fit long glosses
    - build_wordmeanings.py: quran.com now 403s the default python-urllib
    user-agent; send a browser UA + Accept header so the fetch works again.
    - scene_tafsir_play.c: real glosses like "those who earned (Your) wrath"
    overflowed a choice row. draw_fit() shrinks font_small -> font_tiny and
    finally ".."-truncates, applied to choices and assemble tiles/rows.
    [build_wordmeanings.py, scene_tafsir_play.c]
2026-09-13 Enclosure: fit screen to measured module, square NAV, lower screen off the lip
    Follow-up fixes to Rev F after test-fitting real parts:
    - Screen window 54 -> 55.5mm so the actual glass fits (was clipping);
    retention now via the top/bottom lip (91 vs 88) + flush bond, side lip ~0.
    - NAV opening 10.4 -> 11.0mm square with a near-sharp 0.5mm corner radius
    (the 1.0mm radius pinched the square switch's corners so it wouldn't seat).
    - Lowered the screen 3mm (SCR_CY 104->101): the 93mm recess top was poking
    into the top snap-lip (~150.5 vs lip ~149.6); now ~147.5 with clearance.
    Walked the mic (48->46) and D-pad (27->25) down with it to keep the gaps.
    Regenerated STEP/STL, renders and pane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
    [lid.step, lid.stl, qurannode_enclosure.FCStd, qurannode_enclosure.step, tray.step]
2026-09-15 fetch_sample: detect CDN/timeline mismatch, fall back to everyayah clips
    The qdc API's verse timings for surah 2 describe a 232MB/8655s master, but
    download.quranicaudio.com serves a different 137MB/9685s encode of the same
    recitation (~3.6s more inter-ayah pause each ayah). Slicing that file at the
    API's timestamps drifts from ~0 at 2:1 to +1029s by 2:286, so every clip
    contained audio from the wrong part of the surah — the real cause of the
    Baqarah-only "highlight completely off" report (the earlier timestamp_to
    truncation was a symptom of the same swap). Surah 2 is the only affected
    file of 114 (audited API file_size vs CDN content-length).
    Detect the swap by comparing the downloaded f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
    [fetch_sample.py]
2026-09-16 PCB: custom mainboard (KiCad) — netlist, placement/route pipeline, routed board
    First integrated mainboard for the QuranNode, replacing the breakout-board
    prototype. Built via a scripted pipeline: SKiDL netlist -> pcbnew placement ->
    FreeRouting autoroute -> SES import, all reproducible from hardware/pcb/kicad/.
    Board (qurannode.kicad_pcb): 4-layer, 62.8 x 150 mm outline derived from the
    enclosure, GND + 3V3 inner planes, ~88 parts, ~92% autorouted (last mile is a
    GUI finish). Opens in KiCad.
    Design highlights:
    - ESP32-S3 + PCM5102A DAC + PAM8302A amp + INMP441 mic + TP4056 charger +
    TPS63020 buck-boost + USB-C; all footprints resolve against KiCad libs.
    - LCD: horizontal 14-pin header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
    [BOM.csv, qurannode-outline.dxf, qurannode.kicad_pcb, qurannode.kicad_sch]
2026-09-16 PCB: clean up to 0 electrical DRC faults + handoff doc
    Routed board cleaned from 546 DRC / 33 shorts down to 117 DRC / 0 electrical
    faults (0 shorts, 0 clearance, 0 mask bridges), ~94% routed (19 nets left for
    the interactive router). Remaining DRC is footprint-inherent (edge connectors,
    ESP32 thermal pad, mounting holes) + cosmetic (silk-over-pad JLC auto-clips,
    tight courtyards) -- all fab-acceptable.
    What fixed the shorts:
    - Removed the fanout via-in-pads (they bridged neighbour pads -> 31 shorts).
    - half_ext now measures pad EDGES (pos +/- size/2) not centres, so big-pad
    parts (the inductor) can't overlap -> killed the last short.
    - JLC-friendly design rules, refs moved to F.Fab, GND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
    [qurannode.kicad_pcb]
2026-09-16 PCB: finish routing — 0 unconnected, 0 electrical DRC faults, fab outputs
    - J2 microSD + J6 jack: pads were off-board with openings facing INTO the
    board; rotate 180deg + extent-aware clamp (copper stays on-board, jack
    barrel may overhang)
    - Placement occupancy = pads UNION courtyard: parts no longer land under the
    WROOM module's padless antenna end (this is what made DISP_BL/BL_G/SD
    unroutable); all 22 courtyard overlaps gone
    - In2 +3V3 plane: 0.2 clearance / 0.15 min-width so via fences don't split it
    - heal_plane.py: new step (e2) — 2 B.Cu island bridges + INMP441 3V3 fanout,
    the 3 gaps FreeRouting can't see
    - qurannode.ses force-added: FR output varies across versions; heal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
    [qurannode-B_Cu.gbl, qurannode-B_Mask.gbs, qurannode-B_Paste.gbp, qurannode-B_Silkscreen.gbo, qurannode-Edge_Cuts.gm1, qurannode-F_Cu.gtl, qurannode-F_Mask.gts, qurannode-F_Paste.gtp]
